Filip-Kin/frc-radio-kiosk/Radio_Kiosk_v2b/render-iso.png

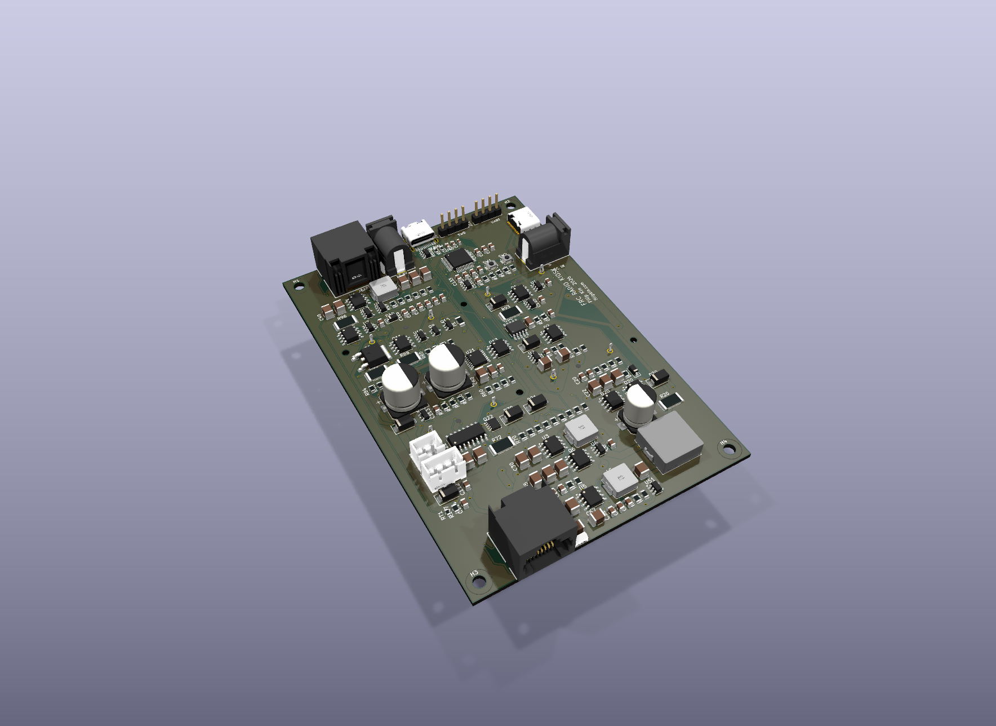
Radio_Kiosk_v2b/render-iso.png
