Filip-Kin/frc-radio-kiosk/Radio_Kiosk_v2d/loon-layout.png

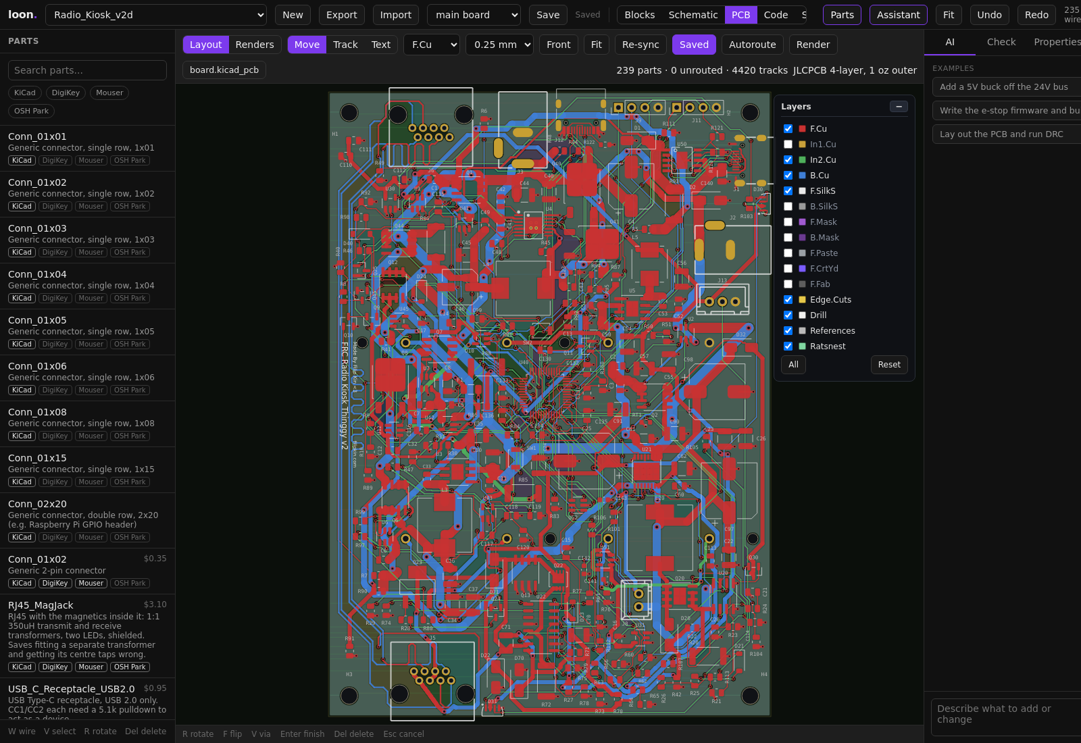
Radio_Kiosk_v2d/loon-layout.png
