Filip-Kin/frc-radio-kiosk/Radio_Kiosk_v2b/NETS-CHANGED.md

# Net changes, schematic 68f2993 -> 1c7bf27 (2026-09-24)

## New parts

C3 C4 C5 C8 C12 C13 C14 C15 C16 C26 C48 C49 C119 C120 D23 Q12 Q23 Q24 Q25 Q40 Q41 R5 R6 R27 R28 R29 R44 R45 R46 R47 R64 R65 R66 R113 U12 U31

## Existing pads that moved to another net

| pad | was | now |
|---|---|---|
| C23.1 | PORT_P | BOOST_OUT |
| C24.1 | PORT_P | BOOST_OUT |
| C25.1 | PORT_P | BOOST_OUT |
| C43.1 | U4_BOOT | U4_BST |
| C44.1 | +15V6_BUCK | VIN |
| C50.1 | VIN | +12V |
| C51.1 | VIN | +12V |
| D20.1 | PORT_P | BOOST_OUT |
| D22.2 | PORT_N | GND |
| D30.1 | LED_D0 | LED_D0R |
| D71.1 | PSE_AGND | PORT_P |
| J13.2 | LED_D2 | LED_D2W |
| Q8.3 | PACK_F | BK_MID |
| Q9.2 | GND | BK_ARM |
| Q10.1 | BK_KILL | BK_EN |
| Q10.3 | BK_DRV | BK_ARM |
| Q11.1 | GND | TEST_LOAD |
| Q11.3 | GND | TEST_NODE |
| Q13.4 | PASSIVE_EN | PASSIVE_EN5 |
| R22.1 | PORT_P | BOOST_OUT |
| R40.1 | +15V6_BUCK | U4_FB |
| R40.2 | U4_FB | GND |
| R41.1 | U4_FB | +15V6_BUCK |
| R41.2 | GND | U4_FB |
| R80.1 | PACK_F | BK_MID |
| R85.1 | PACK_F | BK_MID |
| R86.1 | PACK_F | BK_MID |
| R88.1 | PACK_F | BK_MID |
| R89.1 | BK_KILL | BK_EN |
| R92.1 | LAPTOP_EN | U4_EN |
| R103.2 | LED_D0 | LED_D0R |
| U1.3 | VIN_USBS | USB_EN |
| U4.1 | GND | U4_VCC |
| U4.3 | LAPTOP_EN | U4_EN |
| U4.4 | N$5 | U4_FB |
| U4.5 | U4_FB | GND |
| U4.6 | U4_VCC | U4_SS |
| U4.7 | U4_BOOT | U4_RON |
| U4.8 | U4_SW | U4_ILIM |
| U5.2 | VIN | +12V |
| U5.3 | VIN | +12V |
| U21.3 | GND | +12V |
| U40.18 | N$25 | PORT_SENSE |
| U40.31 | BK_KILL | BK_EN |
| U40.38 | N$26 | PORT_SW |
| U40.46 | N$27 | USB_DIS |
| U43.1 | LAPTOP_ISENSE | LAPTOP_CC |
| U43.3 | LAPTOP_ILIM_N | LAPTOP_ISENSE_F |
| U43.4 | LAPTOP_CC | LAPTOP_ILIM_N |

## Nets gone

BK_KILL U4_BOOT

## Nets new

BK_ARM BK_EN BK_MID BOOST_OUT LAPTOP_ISENSE_F LED_D0R LED_D2W PASSIVE_EN5 PORT_SENSE PORT_SW PORT_SW_D PORT_SW_G U12_GATE U12_VCAP U4_BST U4_EN U4_HG U4_ILIM U4_LG U4_RON U4_SS USB_DIS USB_EN
