Filip-Kin/frc-radio-kiosk/Radio_Kiosk_v2/layers.png

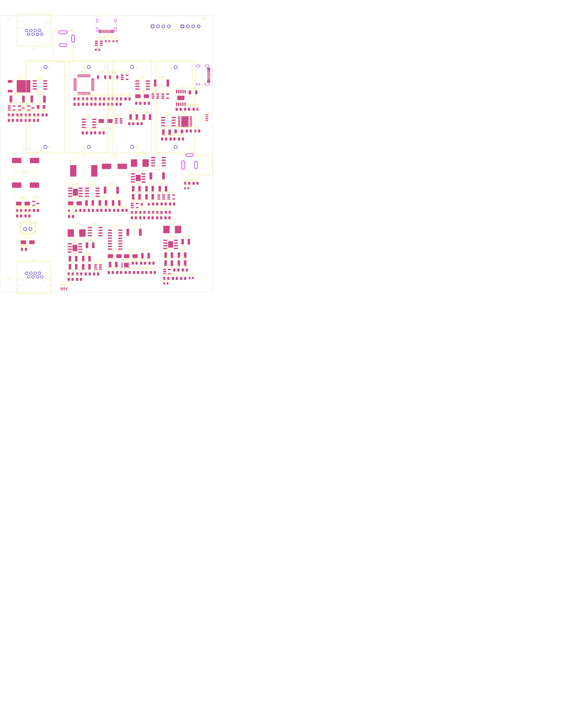
Radio_Kiosk_v2/layers.png
