Filip-Kin/frc-radio-kiosk/Radio_Kiosk_v2/render-bottom.png

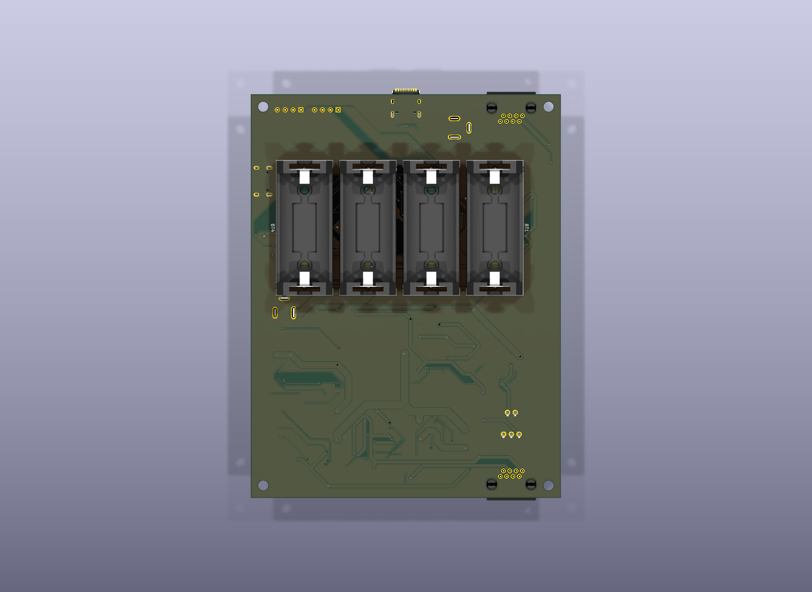
Radio_Kiosk_v2/render-bottom.png
