Filip-Kin/frc-radio-kiosk/Radio_Kiosk_v2/render-top.png

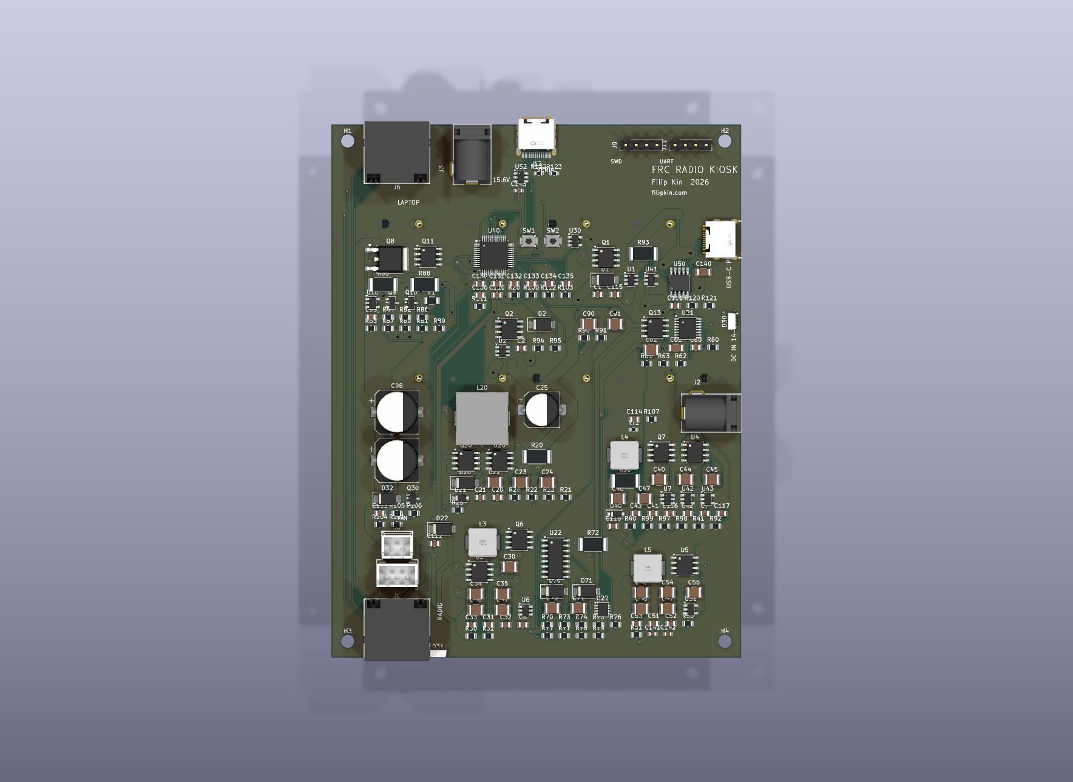
Radio_Kiosk_v2/render-top.png
