Filip-Kin/frc-radio-kiosk/Radio_Kiosk_v2b/audit-top.png

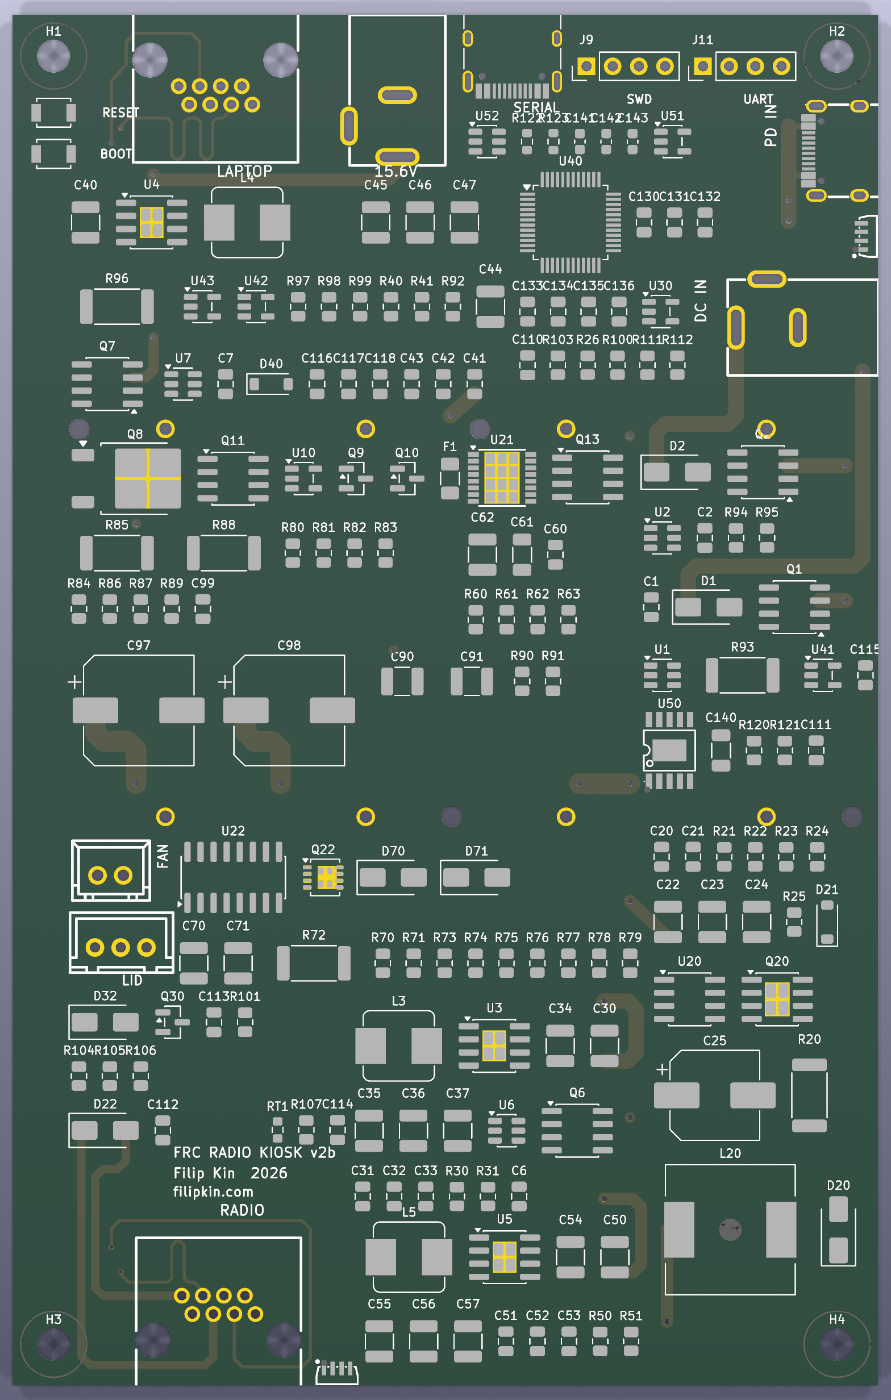
Radio_Kiosk_v2b/audit-top.png
