Filip-Kin/frc-radio-kiosk/Radio_Kiosk_v2b/d30-tilt.png

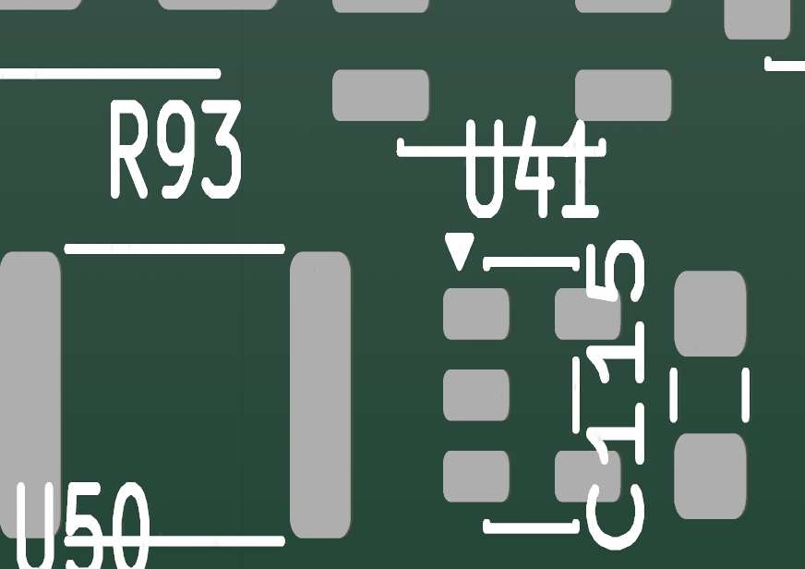
Radio_Kiosk_v2b/d30-tilt.png
