Filip-Kin/frc-radio-kiosk/Radio_Kiosk_v2b/d31-tilt.png

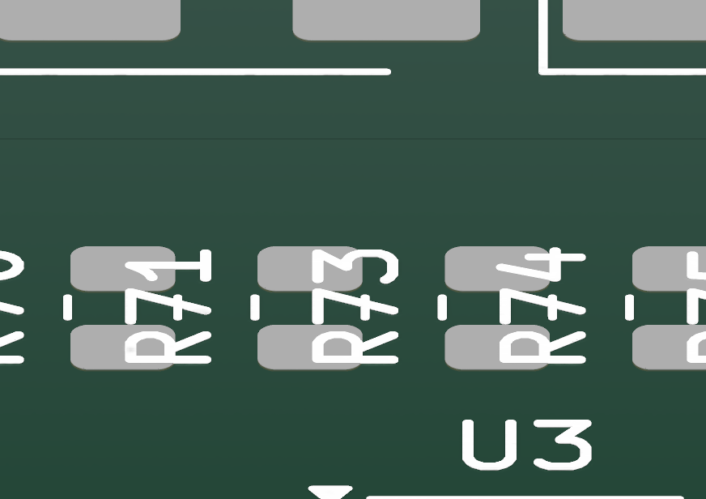
Radio_Kiosk_v2b/d31-tilt.png
