Filip-Kin/frc-radio-kiosk/Radio_Kiosk_v2b/d31-top.png

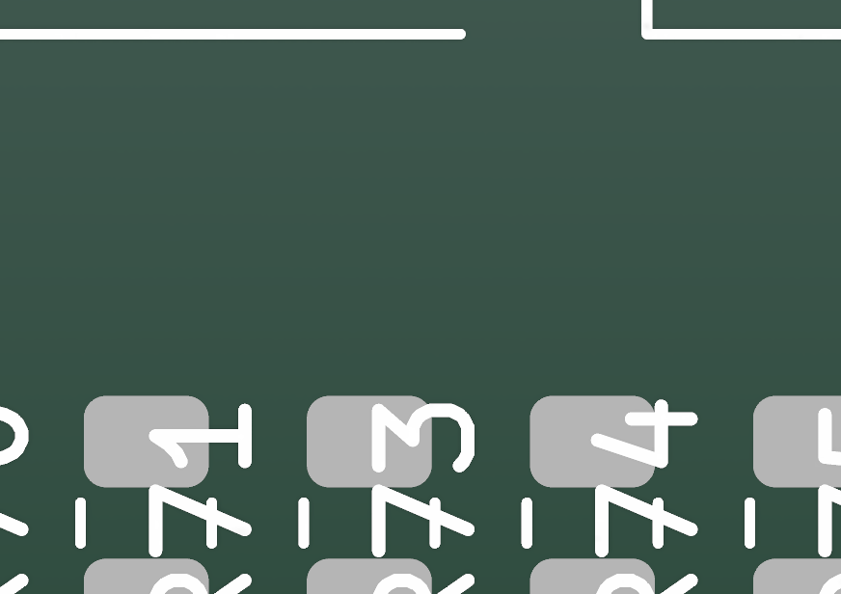
Radio_Kiosk_v2b/d31-top.png
