Filip-Kin/frc-radio-kiosk/Radio_Kiosk_v2b/render-bottom.png

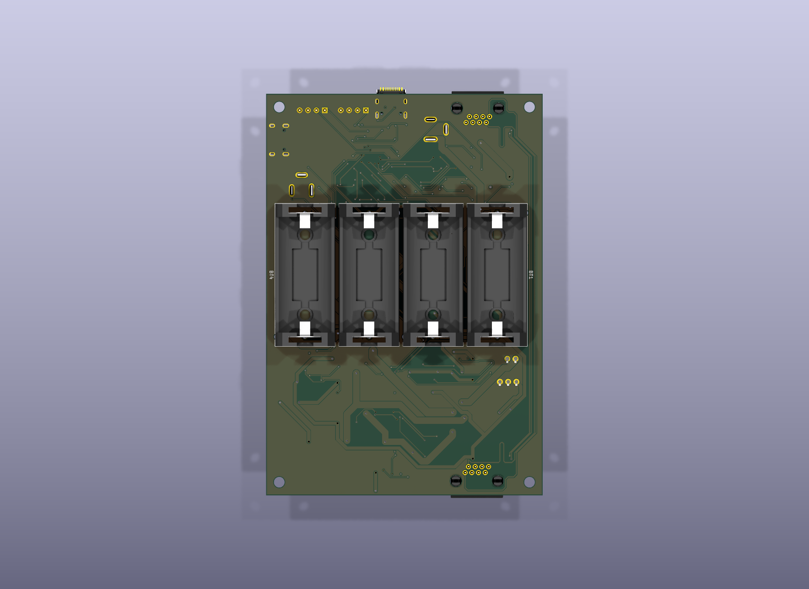
Radio_Kiosk_v2b/render-bottom.png
