Filip-Kin/frc-radio-kiosk/Radio_Kiosk_v2b/render-top.png

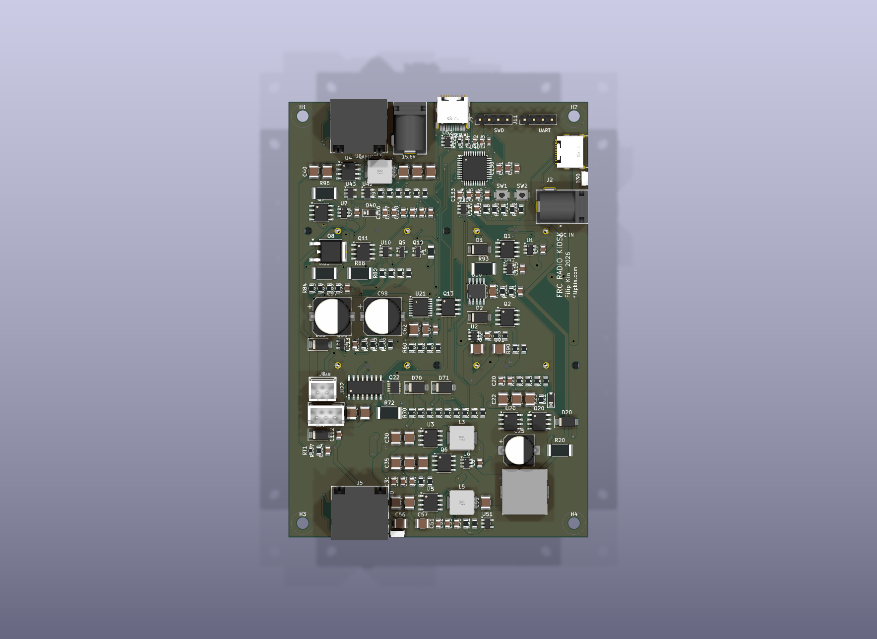
Radio_Kiosk_v2b/render-top.png
