Filip-Kin/frc-radio-kiosk/Radio_Kiosk_v2d/plot-layers.png

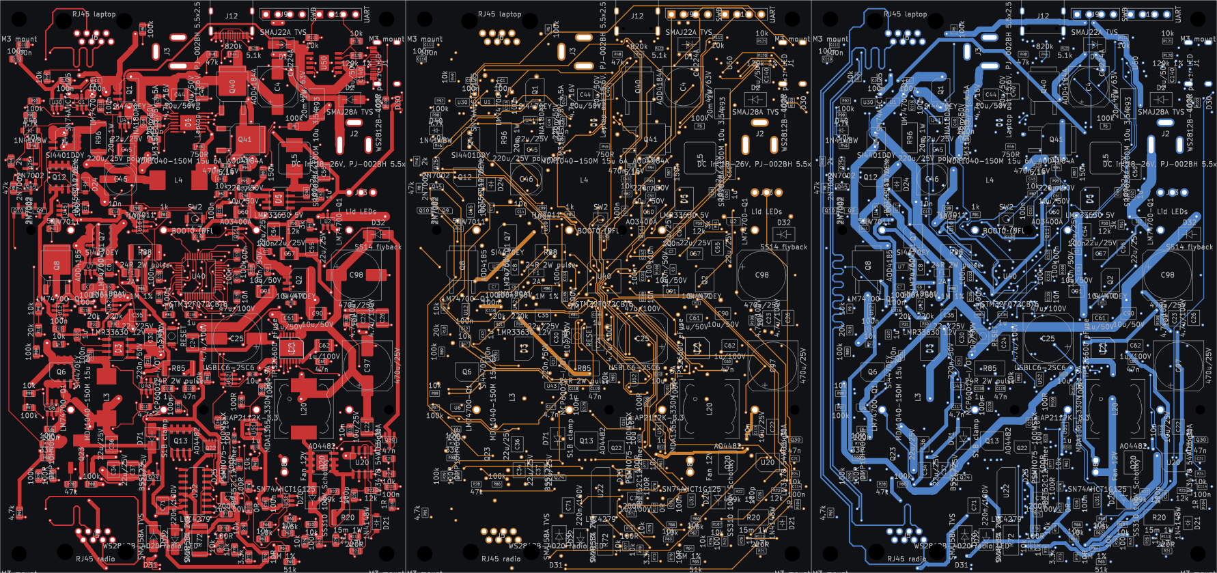
Radio_Kiosk_v2d/plot-layers.png
