Filip-Kin/frc-radio-kiosk/Radio_Kiosk_v2d/plot-top.png

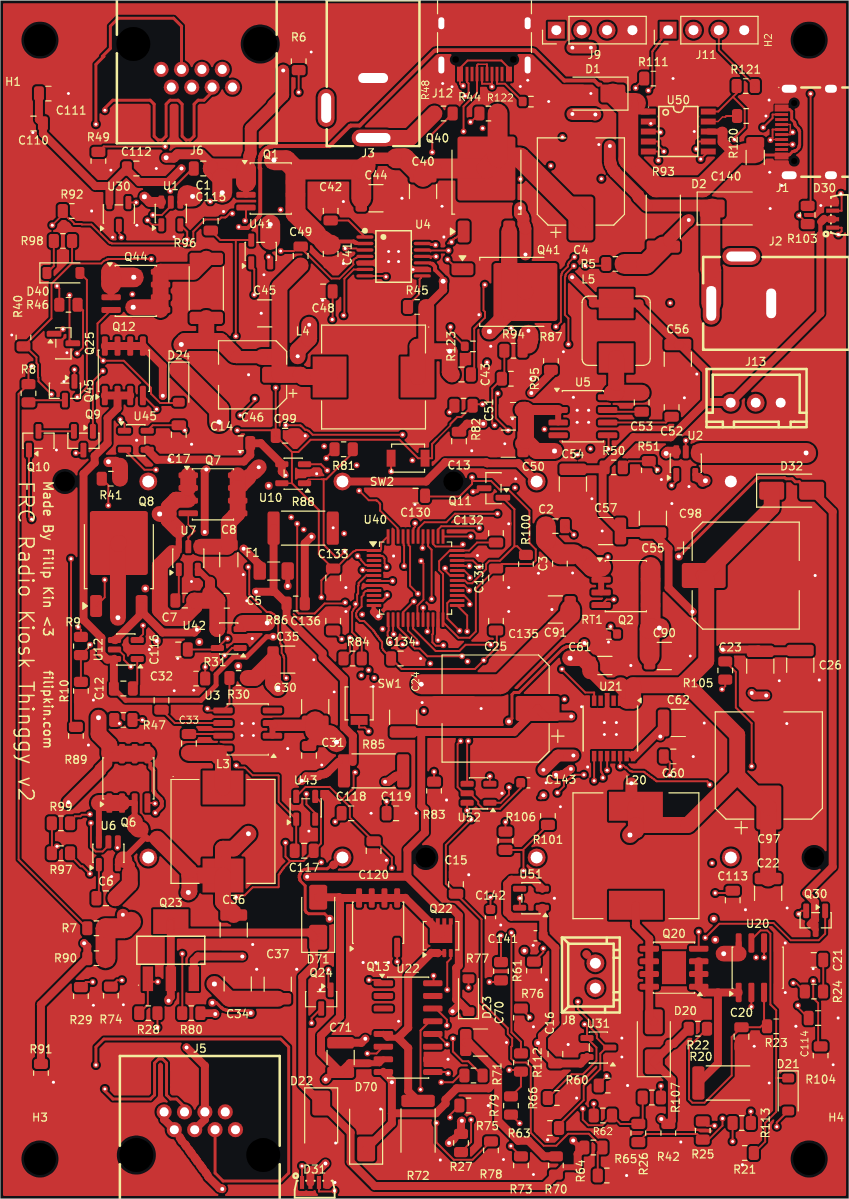
Radio_Kiosk_v2d/plot-top.png
