Filip-Kin/frc-radio-kiosk/Radio_Kiosk_v2d/fab/v2d-bom-jlc-smt-tht.xlsx

Comment | Designator | Footprint | LCSC Part #
100n | C1,C2,C6,C7,C12,C13,C16,C17,C33,C48,C53,C99,C110,C111,C112,C114,C115,C116,C120,C131,C132,C133,C136 | C_0805_2012Metric | C28233
100n/50V | C3,C5 | C_0805_2012Metric | C49678
47u/63V | C4 | CP_Elec_8x10.5 | C970680
1u/50V | C8,C61,C140 | C_1206_3216Metric | C1848
10n | C14,C15,C113,C135 | C_0805_2012Metric | C1710
100p | C20 | C_0805_2012Metric | C1790
47n | C21,C60,C119 | C_0805_2012Metric | C53134
10u/25V | C22 | C_1210_3225Metric | C53084452
4.7u/100V | C23,C24,C26 | C_1210_3225Metric | C337978
47u/100V | C25 | CP_Elec_10x10.5 | C970681
10u/50V | C30,C40,C50,C90,C91,C44 | C_1210_3225Metric | C53084452
220n/50V | C31,C41,C51 | C_0805_2012Metric | C5378
1u | C32,C52,C118,C134 | C_0805_2012Metric | C28323
22u/25V | C34,C35,C36,C37,C45,C54,C55,C56,C57 | C_1210_3225Metric | C53084530
4.7u/16V | C42 | C_0805_2012Metric | C1779
470n/16V | C43 | C_0805_2012Metric | C13967
220u/25V polymer | C46 | CP_Elec_6.3x7.7 | C2981459
2.2n | C49 | C_0805_2012Metric | C28260
1u/100V | C62,C70 | C_1210_3225Metric | C24365
220n/100V | C71 | C_1210_3225Metric | C72067
470u/25V | C97,C98 | CP_Elec_10x10.5 | C346948
4.7n | C117 | C_0805_2012Metric | C1744
4.7u | C130 | C_0805_2012Metric | C1779
1u | C141 | C_0603_1608Metric | C15849
10u | C142,C143 | C_0603_1608Metric | C19702
SMAJ22A TVS | D1 | D_SMA | C148220
SMAJ28A TVS | D2 | D_SMA | C148227
SS310 100V Schottky | D20 | D_SMA | C15874
1N4148W | D21,D40 | D_SOD-123 | C81598
SMAJ58A TVS | D22,D70 | D_SMA | C10762
BZT52C12 zener | D23,D24 | D_SOD-123 | C12747
WS2812B-4020 power LED | D30 | LED-SMD_WS2812B-4020 | C965557
WS2812B-4020 radio LED | D31 | LED-SMD_WS2812B-4020 | C965557
SS14 flyback | D32 | D_SMA | C2480
S1B clamp | D71 | D_SMA | C96324
2A | F1 | Fuse_1206_3216Metric | C2838912
USB-C PD in | J1 | USB-C_TYPE-C-31-M-12 | C165948
DC in 18-26V, PJ-002BH 5.5x2.5 | J2 | DC-IN-TH_PJ-002BH | C22359705
Laptop out 15.6V, PJ-002BH 5.5x2.5 (v1 jack) | J3 | DC-IN-TH_PJ-002BH | C22359705
RJ45 radio | J5 | RJ45-TH_R-RJ45R08P-A004 | C385834
RJ45 laptop | J6 | RJ45-TH_R-RJ45R08P-A004 | C385834
Fan 12V | J8 | CONN-TH_XH-2A | C20079
USB-C | J12 | USB_C_Receptacle_HRO_TYPE-C-31-M-12 | C165948
Lid LEDs | J13 | CONN-TH_XH-3A | C2316
MDA1040-150M 15u 6A | L3,L4 | IND-SMD_L10.0-W10.0-APS10A40M470 | C2847554
SRP7028A-100M 10u 3.5A | L5 | L_Bourns_SRP7028A_7.3x6.6mm | C2687402
MDA1365-330M 33u 9A | L20 | L_12x12mm_H8mm | C2847586
SI4470EY | Q1,Q2,Q6,Q7,Q12 | SOIC-8_3.9x4.9mm_P1.27mm | C7568913
AOD4185 | Q8 | TO-252-2 | C400894
2N7002 | Q9,Q10,Q25,Q45 | SOT-23 | C8545
AO3400A | Q11,Q30 | SOT-23 | C20917
AO4482 | Q13,Q20 | SOIC-8_3.9x4.9mm_P1.27mm | C192576
PSMN075-100MSEX | Q22 | LFPAK33 | C478016
DMP10H400SE | Q23 | SOT-223_L6.5-W3.5-P2.30-LS7.0-BR | C156277
BSS123 | Q24 | SOT-23 | C78755
AOD4184A | Q40,Q41 | TO-252-2 | C99124
SI4401DDY | Q44 | SOIC-8_3.9x4.9mm_P1.27mm | C72317
100k | R5,R6,R29,R42,R80,R89,R92,R97,R100,R101 | R_0805_2012Metric | C149504
10k | R7,R9,R24,R26,R27,R46,R47,R49,R61,R62,R63,R66,R78,R79,R82,R83,R99,R105,R107,R111,R121 | R_0805_2012Metric | C17414
47k | R8,R21,R28,R48 | R_0805_2012Metric | C17713
20k | R10,R31 | R_0805_2012Metric | C4328
15m 1W | R20 | R_2512_6332Metric | C44883
499k 1% | R22 | R_0805_2012Metric | C17721
12k | R23,R50 | R_0805_2012Metric | C17444
1k | R25,R81 | R_0805_2012Metric | C17513
220k | R30 | R_0805_2012Metric | C17556
2k | R40 | R_0805_2012Metric | C17604
51k | R41,R65 | R_0805_2012Metric | C17737
820k | R44 | R_0805_2012Metric | C50136
750R | R45 | R_0805_2012Metric | C17818
3k | R51 | R_0805_2012Metric | C17661
5.6k | R60 | R_0805_2012Metric | C4382
1M 1% | R64,R86 | R_0805_2012Metric | C17514
10R | R70 | R_0805_2012Metric | C17415
200R | R71 | R_0805_2012Metric | C17540
0.1R 1% 2W | R72 | R_2512_6332Metric | C844904
3.3k | R73 | R_0805_2012Metric | C26010
100R | R74,R75,R76,R77,R103,R106 | R_0805_2012Metric | C17408
1M | R84 | R_0805_2012Metric | C17514
24R 2W pulse | R85,R88 | R_2512_6332Metric | C25476
150k | R87 | R_0805_2012Metric | C17470
33k | R90,R94 | R_0805_2012Metric | C17633
4.7k | R91,R95,R98 | R_0805_2012Metric | C17673
20m 1W | R93,R96 | R_2512_6332Metric | C2885416
1R | R104 | R_0805_2012Metric | C25271
0R | R112 | R_0805_2012Metric | C17477
220R | R113 | R_0805_2012Metric | C17557
120k 1% | R120 | R_0805_2012Metric | C17436
5.1k | R122,R123 | R_0603_1608Metric | C23186
10k NTC | RT1 | R_0603_1608Metric | C13564
RESET | SW1 | SW_SPST_B3U-1000P | C231329
BOOT0 (DFU) | SW2 | SW_SPST_B3U-1000P | C231329
LM74700-Q1 | U1,U2,U6,U7,U12 | SOT-23-6 | C2941042
LMR33630 12V | U3 | SOIC-8-1EP_3.9x4.9mm_P1.27mm_EP2.29x3mm | C841384
LM3150 15.75V 4.5A | U4 | HTSSOP-14_L5.0-W4.4-P0.65-LS6.4-BL-EP | C48112
LMR33630 5V | U5 | SOIC-8-1EP_3.9x4.9mm_P1.27mm_EP2.29x3mm | C841384
TLV7011 | U10,U45 | SOT-23-5 | C702117
LM3478 54V boost | U20 | SOIC-8_3.9x4.9mm_P1.27mm | C115907
TPS26600 eFuse | U21 | HTSSOP-16-1EP_4.4x5mm_P0.65mm_EP3.4x5mm | C544399
LTC4279 | U22 | SOIC-16_3.9x9.9mm_P1.27mm | C687935
SN74AHCT1G125 | U30,U31 | SOT-23-5 | C7484
STM32F072CBT6 | U40 | LQFP-48_7x7mm_P0.5mm | C81720
INA180A1 | U41,U42 | SOT-23-5 | C122228
MCP6001T-I/OT | U43 | SOT-23-5 | C116490
CH224A | U50 | ESSOP-10_CH224A | C42459160
AP2112K-3.3 | U51 | SOT-23-5 | C51118
USBLC6-2SC6 | U52 | SOT-23-6 | C7519
