Filip-Kin/frc-radio-kiosk/Radio_Kiosk_v1/fab/3D_PCB1_2026-03-25.step

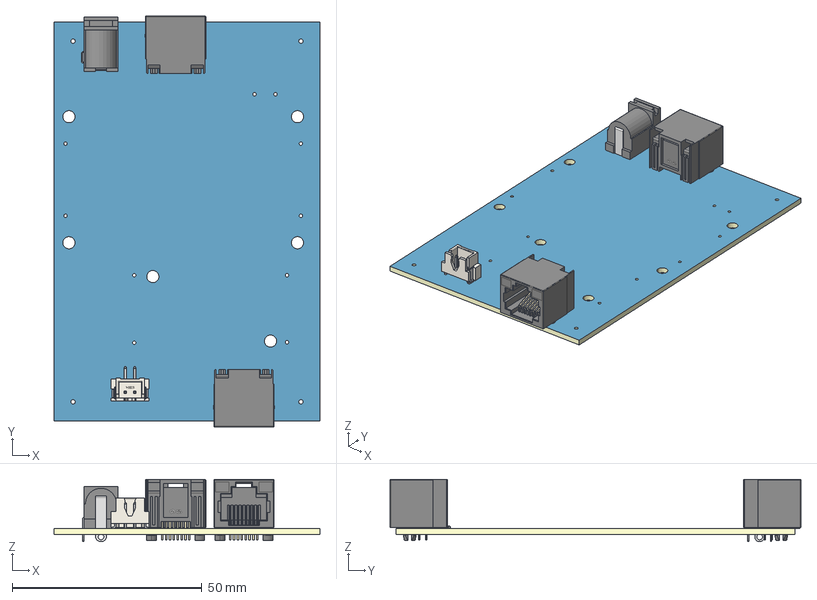
[picture p15: CAD file, 2026-10-11, an earlier design]
Radio_Kiosk_v1/fab/3D_PCB1_2026-03-25.step
70.0 x 108.3 x 16.4 mm
Board~hxvB
TopCopper~hxvB
BottomCopper~hxvB
TopFpcStiffener~hxvB
BottomFpcStiffener~hxvB
CONN-SMD_2P-P2.54_XH2.54-2AB~CONN-SMD_XH2.54-LS-2P~hxvB
DC-IN-TH_PJ-002BH~DC-IN-TH_PJ-002BH~hxvB
RJ45-TH_R-RJ45R08P-A004~RJ45-TH_L15.9-W15.1-H12.6~hxvB x 2
