Filip-Kin/frc-radio-kiosk/Radio_Kiosk_v2d/board.kicad_pcb

## KiCad design Radio_Kiosk_v2d/board.kicad_pcb (2026-09-26)

Schematic: board.kicad_sch, FRC Radio Kiosk v2

Parts:
BT1, BT2, BT3, BT4: CR123A; BAT-TH_BH-123A-A5BJ002; LCSC C5290177
C1, C2, C6, C7, C12, C13, C16, C17, C33, C48, C53, C99, C110, C111, C112, C114, C115, C116, C120, C131, C132, C133, C136: 100n; C_0805_2012Metric; LCSC C28233
C3, C5: 100n/50V; C_0805_2012Metric; LCSC C49678
C4: 47u/63V; CP_Elec_8x10.5; LCSC C970680
C8, C61, C140: 1u/50V; C_1206_3216Metric; LCSC C1848
C14, C15, C113, C135: 10n; C_0805_2012Metric; LCSC C1710
C20: 100p; C_0805_2012Metric; LCSC C1790
C21, C60, C119: 47n; C_0805_2012Metric; LCSC C53134
C22: 10u/25V; C_1210_3225Metric; LCSC C53084452
C23, C24, C26: 4.7u/100V; C_1210_3225Metric; LCSC C337978
C25: 47u/100V; CP_Elec_10x10.5; LCSC C970681
C30, C40, C44, C50, C90, C91: 10u/50V; C_1210_3225Metric; LCSC C53084452
C31, C41, C51: 220n/50V; C_0805_2012Metric; LCSC C5378
C32, C52, C118, C134: 1u; C_0805_2012Metric; LCSC C28323
C34, C35, C36, C37, C45, C54, C55, C56, C57: 22u/25V; C_1210_3225Metric; LCSC C53084530
C42: 4.7u/16V; C_0805_2012Metric; LCSC C1779
C43: 470n/16V; C_0805_2012Metric; LCSC C13967
C46: 220u/25V polymer; CP_Elec_6.3x7.7; LCSC C2981459
C49: 2.2n; C_0805_2012Metric; LCSC C28260
C62, C70: 1u/100V; C_1210_3225Metric; LCSC C24365
C71: 220n/100V; C_1210_3225Metric; LCSC C72067
C97, C98: 470u/25V; CP_Elec_10x10.5; LCSC C346948
C117: 4.7n; C_0805_2012Metric; LCSC C1744
C130: 4.7u; C_0805_2012Metric; LCSC C1779
C141: 1u; C_0603_1608Metric; LCSC C15849
C142, C143: 10u; C_0603_1608Metric; LCSC C19702
D1: SMAJ22A TVS; D_SMA; LCSC C148220
D2: SMAJ28A TVS; D_SMA; LCSC C148227
D20: SS310 100V Schottky; D_SMA; LCSC C15874
D21, D40: 1N4148W; D_SOD-123; LCSC C81598
D22, D70: SMAJ58A TVS; D_SMA; LCSC C10762
D23, D24: BZT52C12 zener; D_SOD-123; LCSC C12747
D30: WS2812B-4020 power LED; LED-SMD_WS2812B-4020; LCSC C965557
D31: WS2812B-4020 radio LED; LED-SMD_WS2812B-4020; LCSC C965557
D32: SS14 flyback; D_SMA; LCSC C2480
D71: S1B clamp; D_SMA; LCSC C96324
F1: 2A; Fuse_1206_3216Metric; LCSC C2838912
J1: USB-C PD in; USB-C_TYPE-C-31-M-12; LCSC C165948
J2: DC in 18-26V, PJ-002BH 5.5x2.5; DC-IN-TH_PJ-002BH; LCSC C22359705
J3: Laptop out 15.6V, PJ-002BH 5.5x2.5 (v1 jack); DC-IN-TH_PJ-002BH; LCSC C22359705
J5: RJ45 radio; RJ45-TH_R-RJ45R08P-A004; LCSC C385834
J6: RJ45 laptop; RJ45-TH_R-RJ45R08P-A004; LCSC C385834
J8: Fan 12V; CONN-TH_XH-2A; LCSC C20079
J9: SWD; PinHeader_1x04_P2.54mm_Vertical
J11: UART; PinHeader_1x04_P2.54mm_Vertical
J12: USB-C; USB_C_Receptacle_HRO_TYPE-C-31-M-12; LCSC C165948
J13: Lid LEDs; CONN-TH_XH-3A; LCSC C2316
L3, L4: MDA1040-150M 15u 6A; IND-SMD_L10.0-W10.0-APS10A40M470; LCSC C2847554
L5: SRP7028A-100M 10u 3.5A; L_Bourns_SRP7028A_7.3x6.6mm; LCSC C2687402
L20: MDA1365-330M 33u 9A; L_12x12mm_H8mm; LCSC C2847586
Q1, Q2, Q6, Q7, Q12: SI4470EY; SOIC-8_3.9x4.9mm_P1.27mm; LCSC C7568913
Q8: AOD4185; TO-252-2; LCSC C400894
Q9, Q10, Q25, Q45: 2N7002; SOT-23; LCSC C8545
Q11, Q30: AO3400A; SOT-23; LCSC C20917
Q13, Q20: AO4482; SOIC-8_3.9x4.9mm_P1.27mm; LCSC C192576
Q22: PSMN075-100MSEX; LFPAK33; LCSC C478016
Q23: DMP10H400SE; SOT-223_L6.5-W3.5-P2.30-LS7.0-BR; LCSC C156277
Q24: BSS123; SOT-23; LCSC C78755
Q40, Q41: AOD4184A; TO-252-2; LCSC C99124
Q44: SI4401DDY; SOIC-8_3.9x4.9mm_P1.27mm; LCSC C72317
R5, R6, R29, R42, R80, R89, R92, R97, R100, R101: 100k; R_0805_2012Metric; LCSC C149504
R7, R9, R24, R26, R27, R46, R47, R49, R61, R62, R63, R66, R78, R79, R82, R83, R99, R105, R107, R111, R121: 10k; R_0805_2012Metric; LCSC C17414
R8, R21, R28, R48: 47k; R_0805_2012Metric; LCSC C17713
R10, R31: 20k; R_0805_2012Metric; LCSC C4328
R20: 15m 1W; R_2512_6332Metric; LCSC C44883
R22: 499k 1%; R_0805_2012Metric; LCSC C17721
R23, R50: 12k; R_0805_2012Metric; LCSC C17444
R25, R81: 1k; R_0805_2012Metric; LCSC C17513
R30: 220k; R_0805_2012Metric; LCSC C17556
R40: 2k; R_0805_2012Metric; LCSC C17604
R41, R65: 51k; R_0805_2012Metric; LCSC C17737
R44: 820k; R_0805_2012Metric; LCSC C50136
R45: 750R; R_0805_2012Metric; LCSC C17818
R51: 3k; R_0805_2012Metric; LCSC C17661
R60: 5.6k; R_0805_2012Metric; LCSC C4382
R64, R86: 1M 1%; R_0805_2012Metric; LCSC C17514
R70: 10R; R_0805_2012Metric; LCSC C17415
R71: 200R; R_0805_2012Metric; LCSC C17540
R72: 0.1R 1% 2W; R_2512_6332Metric; LCSC C844904
R73: 3.3k; R_0805_2012Metric; LCSC C26010
R74, R75, R76, R77, R103, R106: 100R; R_0805_2012Metric; LCSC C17408
R84: 1M; R_0805_2012Metric; LCSC C17514
R85, R88: 24R 2W pulse; R_2512_6332Metric; LCSC C25476
R87: 150k; R_0805_2012Metric; LCSC C17470
R90, R94: 33k; R_0805_2012Metric; LCSC C17633
R91, R95, R98: 4.7k; R_0805_2012Metric; LCSC C17673
R93, R96: 20m 1W; R_2512_6332Metric; LCSC C2885416
R104: 1R; R_0805_2012Metric; LCSC C25271
R112: 0R; R_0805_2012Metric; LCSC C17477
R113: 220R; R_0805_2012Metric; LCSC C17557
R120: 120k 1%; R_0805_2012Metric; LCSC C17436
R122, R123: 5.1k; R_0603_1608Metric; LCSC C23186
RT1: 10k NTC; R_0603_1608Metric; LCSC C13564
SW1: RESET; SW_SPST_B3U-1000P; LCSC C231329
SW2: BOOT0 (DFU); SW_SPST_B3U-1000P; LCSC C231329
U1, U2, U6, U7, U12: LM74700-Q1; SOT-23-6; LCSC C2941042
U3: LMR33630 12V; SOIC-8-1EP_3.9x4.9mm_P1.27mm_EP2.29x3mm; LCSC C841384
U4: LM3150 15.75V 4.5A; HTSSOP-14_L5.0-W4.4-P0.65-LS6.4-BL-EP; LCSC C48112
U5: LMR33630 5V; SOIC-8-1EP_3.9x4.9mm_P1.27mm_EP2.29x3mm; LCSC C841384
U10, U45: TLV7011; SOT-23-5; LCSC C702117
U20: LM3478 54V boost; SOIC-8_3.9x4.9mm_P1.27mm; LCSC C115907
U21: TPS26600 eFuse; HTSSOP-16-1EP_4.4x5mm_P0.65mm_EP3.4x5mm; LCSC C544399
U22: LTC4279; SOIC-16_3.9x9.9mm_P1.27mm; LCSC C687935
U30, U31: SN74AHCT1G125; SOT-23-5; LCSC C7484
U40: STM32F072CBT6; LQFP-48_7x7mm_P0.5mm; LCSC C81720
U41, U42: INA180A1; SOT-23-5; LCSC C122228
U43: MCP6001T-I/OT; SOT-23-5; LCSC C116490
U50: CH224A; ESSOP-10_CH224A; LCSC C42459160
U51: AP2112K-3.3; SOT-23-5; LCSC C51118
U52: USBLC6-2SC6; SOT-23-6; LCSC C7519

Connections:
+3V3: C17.1, C99.1, C115.1, C116.1, C120.1, C130.1, C131.1, C132.1, C133.1, C142.1, J9.3, J11.3, R26.1, R62.1, R79.1, R82.1, R107.1, R112.1, R121.1, SW2.2, U10.5 (VCC), U40.1 (VBAT), U40.24 (VDD), U40.36 (VDDIO2), U40.48 (VDD), U41.5 (VS), U42.5 (VS), U43.5 (VDD), U45.5 (VCC), U51.5 (VOUT)
+5V: C16.1, C54.1, C55.1, C56.1, C57.1, C110.1, C111.1, C112.1, C141.1, D30.2 (VDD), D31.2 (VDD), J13.1 (5V), L5.2, R50.1, U30.5 (VCC), U31.5 (VCC), U51.1 (VIN), U51.3 (EN)
+12V: C22.1, C50.1, C51.1, C61.1, C97.1, C98.1, D32.1 (K), J8.1, L20.1, Q6.5 (D), Q6.6 (D), Q6.7 (D), Q6.8 (D), Q8.2 (D), U5.2 (VIN), U5.3 (EN), U6.4 (CATHODE), U20.8 (VIN), U21.1 (IN), U21.2 (IN), U21.3 (UVLO)
+12V_BUCK: C6.2, C34.1, C35.1, C36.1, C37.1, L3.2, Q6.1 (S), Q6.2 (S), Q6.3 (S), R30.1, U6.3 (EN), U6.6 (ANODE)
+15V6_BUCK: C45.1, C46.1, C49.1, L4.2, R41.1, R96.1, U42.3 (IN+)
+15V6_S: C5.1, C7.2, Q7.1 (S), Q7.2 (S), Q7.3 (S), Q44.5 (D), Q44.6 (D), Q44.7 (D), Q44.8 (D), R96.2, U7.3 (EN), U7.6 (ANODE), U42.4 (IN-)
BK_ARM: Q9.2 (S), Q10.3 (D)
BK_DRV: Q9.1 (G), R81.2
BK_EN: Q10.1 (G), R89.1, U12.3 (EN), U40.5 (PF0/OSC_IN)
BK_GATE: Q8.1 (G), Q9.3 (D), R80.2
BK_MID: Q8.3 (S), Q12.5 (D), Q12.6 (D), Q12.7 (D), Q12.8 (D), R80.1, R85.1, R86.1, R88.1, U12.4 (CATHODE)
BK_ON: R81.1, R84.1, U10.1 (OUT), U40.6 (PF1/OSC_OUT)
BK_REF: R82.2, R83.1, R84.2, U10.3 (IN+)
BOOST_COMP: R24.1, U20.2 (COMP)
BOOST_COMPC: C21.1, R24.2
BOOST_CS: Q20.1 (S), Q20.2 (S), Q20.3 (S), R20.1, U20.1 (ISEN)
BOOST_DR: Q20.4 (G), U20.6 (DR)
BOOST_FA: D21.1 (K), R21.1, U20.7 (FA/SD)
BOOST_FB: C20.1, R22.2, R23.1, U20.3 (FB)
BOOST_OUT: C23.1, C24.1, C25.1, C26.1, D20.1 (K), D23.1 (K), Q23.3 (S), R22.1, R27.1, R42.1
BOOST_SD: R25.1, R26.2, U40.27 (PB14)
BOOST_SDD: D21.2 (A), R25.2
BOOST_SW: D20.2 (A), L20.2, Q20.5 (D), Q20.6 (D), Q20.7 (D), Q20.8 (D)
BYP_D: Q45.3 (D), R8.2
BYP_EN: Q45.1 (G), U45.1 (OUT)
BYP_G: D24.2 (A), Q44.4 (G), R7.2, R8.1
BYP_REF: R9.2, R10.1, U45.3 (IN+)
CC1: J12.A5 (CC1), R122.1
CC2: J12.B5 (CC2), R123.1
DCIN_SENSE: R94.2, R95.1, U40.19 (PB1/ADC9)
ETH_1: J5.1, J6.1
ETH_2: J5.2, J6.2
ETH_3: J5.3, J6.3
ETH_6: J5.6, J6.6
FAN_G: Q30.1 (G), R101.1, R106.2
FAN_N: D32.2 (A), J8.2, Q30.3 (D)
FAN_PWM: R106.1, U40.40 (PB4)
FAN_SENSE: C113.1, R105.2, U40.18 (PB0/ADC8)
FAN_SHUNT: Q30.2 (S), R104.1, R105.1
GND: BT4.2 (-), C3.2, C4.2, C5.2, C8.2, C13.2, C14.2, C15.2, C16.2, C17.2, C20.2, C21.2, C22.2, C23.2, C24.2, C25.2, C26.2, C30.2, C31.2, C32.2, C34.2, C35.2, C36.2, C37.2, C40.2, C41.2, C42.2, C44.2, C45.2, C46.2, C48.2, C50.2, C51.2, C52.2, C54.2, C55.2, C56.2, C57.2, C60.2, C61.2, C62.2, C70.2, C90.2, C91.2, C97.2, C98.2, C99.2, C110.2, C111.2, C112.2, C113.2, C114.2, C115.2, C116.2, C118.2, C119.2, C120.2, C130.2, C131.2, C132.2, C133.2, C134.2, C135.2, C136.2, C140.2, C141.2, C142.2, C143.2, D1.2 (A), D2.2 (A), D22.2 (A), D30.4 (VSS), D31.4 (VSS), D70.2 (A), J1.1 (SHELL), J1.2 (SHELL), J1.3 (SHELL), J1.4 (SHELL), J1.A1B12 (GND), J1.B1A12 (GND), J2.2 (GND), J3.2 (GND), J9.4, J11.4, J12.A1 (GND), J12.A12, J12.B1 (GND2), J12.B12, J12.S1 (SHIELD), J13.3 (GND), Q10.2 (S), Q11.2 (S), Q13.1 (S), Q13.2 (S), Q13.3 (S), Q24.2 (S), Q25.2 (S), Q41.3 (S), Q45.2 (S), R6.2, R10.2, R20.2, R21.2, R23.2, R29.2, R31.2, R40.2, R42.2, R49.2, R51.2, R60.2, R61.2, R63.2, R65.2, R66.2, R72.2, R73.2, R74.2, R75.2, R76.2, R78.2, R83.2, R87.2, R89.2, R91.2, R92.2, R95.2, R100.2, R101.2, R104.2, R111.2, R120.2, R122.2, R123.2, RT1.2, SW1.2, U1.2 (GND), U2.2 (GND), U3.1 (PGND), U3.9 (AGND), U4.5 (SGND), U4.9 (SGND), U4.14 (PGND), U4.15 (EP), U5.1 (PGND), U5.9 (AGND), U6.2 (GND), U7.2 (GND), U10.2 (VEE), U12.2 (GND), U20.4 (AGND), U20.5 (PGND), U21.5 (OVP), U21.8 (RTN), U21.9 (GND), U21.17 (PAD), U22.4 (VSSK), U22.10 (VEE), U30.1 (OE), U30.3 (GND), U31.1 (OE), U31.3 (GND), U40.8 (VSSA), U40.23 (VSS), U40.35 (VSS), U40.47 (VSS), U41.2 (GND), U42.2 (GND), U43.2 (VSS), U45.2 (VEE), U50.11 (EPAD), U51.2 (GND), U52.2 (GND)
LAPTOP_BYP: R9.1, U40.20 (PB2)
LAPTOP_CC: C117.1, D40.2 (A), U43.1 (OUT)
LAPTOP_CC_D: D40.1 (K), R98.1
LAPTOP_EN: R46.1, U40.46 (PB9)
LAPTOP_ILIM: C118.1, R97.1, R99.2
LAPTOP_ILIM_N: C117.2, R97.2, U43.4 (IN-)
LAPTOP_ILIM_PWM: R99.1, U40.29 (PA8/TIM1_CH1)
LAPTOP_ISENSE: R47.1, U40.14 (PA4/ADC4), U42.1 (OUT)
LAPTOP_ISENSE_F: C119.1, R47.2, U43.3 (IN+)
LAPTOP_OK: R48.2, R49.1, U40.2 (PC13)
LAPTOP_OUT: C8.1, J3.1 (V+), Q7.5 (D), Q7.6 (D), Q7.7 (D), Q7.8 (D), R48.1, U7.4 (CATHODE)
LED_D0: R103.1, U30.4 (Y)
LED_D0R: D30.1 (DIN), R103.2
LED_D1: D30.3 (DOUT), D31.1 (DIN)
LED_D2: D31.3 (DOUT), R113.1
LED_D2W: J13.2 (DATA), R113.2
LED_DATA: U30.2 (A), U40.45 (PB8)
MCU_BOOT0: R111.1, SW2.1, U40.44 (BOOT0)
MCU_NRST: C136.1, SW1.1, U40.7 (NRST)
MCU_VDDA: C134.1, C135.1, R112.2, U40.9 (VDDA)
PACK_1: BT1.2 (-), BT2.1 (+)
PACK_2: BT2.2 (-), BT3.1 (+)
PACK_3: BT3.2 (-), BT4.1 (+)
PACK_F: C12.2, F1.2 (OUT), Q12.1 (S), Q12.2 (S), Q12.3 (S), U12.6 (ANODE)
PACK_P: BT1.1 (+), F1.1 (IN)
PACK_SENSE: C13.1, R86.2, R87.1, U40.12 (PA2/ADC2)
PASSIVE_DVDT: C60.1, U21.12 (dVdT)
PASSIVE_EN: R63.1, U21.7 (SHDN), U31.2 (A), U40.21 (PB10)
PASSIVE_EN5: Q13.4 (G), R66.1, U31.4 (Y)
PASSIVE_FLT: R62.2, U21.14 (FLT), U40.25 (PB12)
PASSIVE_ILIM: R60.1, U21.11 (ILIM)
PASSIVE_IMON: R61.1, U21.10 (IMON), U40.15 (PA5/ADC5)
PD_CC1: J1.A5 (CC1), U50.7 (CC1)
PD_CC2: J1.B5 (CC2), U50.6 (CC2)
PD_CFG1: R120.1, U50.9 (CFG1)
PD_DM: J1.A7 (D-), J1.B7 (D-2), U50.5 (DM)
PD_DP: J1.A6 (D+), J1.B6 (D+2), U50.4 (DP)
PD_PG: R121.2, U40.31 (PA10), U50.10 (PG)
PD_SCL: U40.38 (PA15), U50.2 (CFG2/SCL)
PD_SDA: U40.39 (PB3), U50.3 (CFG3/SDA)
PORT_N: C71.1, D71.2 (A), J5.7, J5.8, Q13.5 (D), Q13.6 (D), Q13.7 (D), Q13.8 (D), Q22.5 (D), U22.7 (OUT)
PORT_P: C62.1, D22.1 (K), D71.1 (K), J5.4, J5.5, Q23.2 (D), Q23.4 (D), R64.1, R70.1, U21.15 (OUT), U21.16 (OUT)
PORT_SENSE: C15.1, R64.2, R65.1, U40.17 (PA7/ADC7)
PORT_SW: Q24.1 (G), R29.1, U40.4 (PC15/OSC32_OUT)
PORT_SW_D: Q24.3 (D), R28.2
PORT_SW_G: D23.2 (A), Q23.1 (G), R27.2, R28.1
PSE_AGND: C70.1, C71.2, D70.1 (K), R70.2, U22.8 (AGND)
PSE_DUALPD: R76.1, U22.14 (DUALPD)
PSE_EN: R77.1, U40.26 (PB13)
PSE_GATE: Q22.4 (G), R71.2
PSE_GATE_DRV: R71.1, U22.6 (GATE)
PSE_LEGACY: R75.1, U22.13 (LEGACY)
PSE_MID: R74.1, U22.1 (MID)
PSE_ON: R79.2, U22.9 (LED), U40.22 (PB11)
PSE_PWRMODE: R73.1, U22.12 (PWRMODE)
PSE_RESET: R77.2, R78.1, U22.16 (RESET)
PSE_SENSE: Q22.1 (S), Q22.2 (S), Q22.3 (S), R72.1, U22.5 (SENSE)
SWCLK: J9.2, U40.37 (PA14/SWCLK)
SWDIO: J9.1, U40.34 (PA13/SWDIO)
TEMP_SENSE: C114.1, R107.2, RT1.1, U40.16 (PA6/ADC6/TIM3_CH1)
TEST_LOAD: Q11.1 (G), R100.1, U40.30 (PA9)
TEST_NODE: Q11.3 (D), R85.2, R88.2
U1_GATE: Q1.4 (G), U1.5 (GATE)
U1_VCAP: C1.1, U1.1 (VCAP)
U2_GATE: Q2.4 (G), U2.5 (GATE)
U2_VCAP: C2.1, U2.1 (VCAP)
U3_BOOT: C33.1, U3.7 (BOOT)
U3_FB: R30.2, R31.1, U3.5 (FB)
U3_SW: C33.2, L3.1, U3.8 (SW)
U3_VCC: C32.1, U3.6 (VCC)
U4_BST: C43.1, U4.12 (BST)
U4_EN: R46.2, R92.1, U4.3 (EN)
U4_FB: C49.2, R40.1, R41.2, R98.2, U4.4 (FB)
U4_HG: Q40.1 (G), U4.11 (HG)
U4_ILIM: R45.1, U4.8 (ILIM)
U4_LG: Q41.1 (G), U4.13 (LG)
U4_RON: R44.2, U4.7 (RON)
U4_SS: C48.1, U4.6 (SS)
U4_SW: C43.2, L4.1, Q40.3 (S), Q41.2 (D), R45.2, U4.10 (SW)
U4_VCC: C42.1, U4.1 (VCC)
U5_BOOT: C53.1, U5.7 (BOOT)
U5_FB: R50.2, R51.1, U5.5 (FB)
U5_SW: C53.2, L5.1, U5.8 (SW)
U5_VCC: C52.1, U5.6 (VCC)
U6_GATE: Q6.4 (G), U6.5 (GATE)
U6_VCAP: C6.1, U6.1 (VCAP)
U7_GATE: Q7.4 (G), U7.5 (GATE)
U7_VCAP: C7.1, U7.1 (VCAP)
U12_GATE: Q12.4 (G), U12.5 (GATE)
U12_VCAP: C12.1, U12.1 (VCAP)
UART_RX: J11.2, U40.43 (PB7)
UART_TX: J11.1, U40.42 (PB6)
USB_D+: U40.33 (PA12/USB_DP), U52.4 (I/O2_OUT)
USB_D-: U40.32 (PA11/USB_DM), U52.6 (I/O1_OUT)
USB_DIS: Q25.1 (G), R6.1, U40.41 (PB5)
USB_DM_CON: J12.A7 (D-), J12.B7 (D-2), U52.1 (I/O1)
USB_DP_CON: J12.A6 (D+), J12.B6 (D+2), U52.3 (I/O2)
USB_EN: Q25.3 (D), R5.2, U1.3 (EN)
USB_ISENSE: U40.13 (PA3/ADC3), U41.1 (OUT)
USB_VBUS: C143.1, J12.A4 (VBUS), J12.A9, J12.B4 (VBUS2), J12.B9, U52.5 (VBUS)
VIN: C4.1, C30.1, C31.1, C40.1, C41.1, C44.1, C90.1, C91.1, D24.1 (K), Q1.5 (D), Q1.6 (D), Q1.7 (D), Q1.8 (D), Q2.5 (D), Q2.6 (D), Q2.7 (D), Q2.8 (D), Q40.2 (D), Q44.1 (S), Q44.2 (S), Q44.3 (S), R7.1, R44.1, R90.1, U1.4 (CATHODE), U2.4 (CATHODE), U3.2 (VIN), U3.3 (EN), U4.2 (VIN)
VIN_DC: C2.2, C3.1, D2.1 (K), J2.1 (V+), Q2.1 (S), Q2.2 (S), Q2.3 (S), R94.1, U2.3 (EN), U2.6 (ANODE)
VIN_SENSE: C14.1, R90.2, R91.1, U10.4 (IN-), U40.11 (PA1/ADC1), U45.4 (IN-)
VIN_USB: C140.1, D1.1 (K), J1.A4B9 (VBUS), J1.B4A9 (VBUS), R93.1, U41.3 (IN+), U50.1 (VHV), U50.8 (VBUS)
VIN_USBS: C1.2, Q1.1 (S), Q1.2 (S), Q1.3 (S), R5.1, R93.2, U1.6 (ANODE), U41.4 (IN-)

Notes on the sheet:
STAGES 1-3 DONE: power tree, radio port, MCU. Stage 4 = the board. Port placement for the board: TOP edge = laptop side (J6 RJ45 laptop, J3 laptop DC out, the USB-C serial). RIGHT edge = power in (J1 PD trigger module, J2 DC jack). BOTTOM edge = radio (J5 RJ45 radio). D30 sits by the power inputs, 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
RADIO PORT: PORT_P = pins 4/5, PORT_N = pins 7/8 (Mode B). Unknown port: boost on, Q23 (PORT_SW) closed, PSE_EN: U22 probes the PD. Valid 802.3 signature within 700 ms: active, U22 powers PORT_N, 54 V on the port. No signature: PORT_SW open, PSE_EN off, PORT_P decays through R64, then PASSIVE_EN: U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
PSE: LTC4279 (SO-16) per datasheet Figure 13. PORT_P is its AGND supply through R70 10R; board GND is its VEE; Q22 (PSMN075-100MSEX, ADI's recommended FET) switches PORT_N through R72 0.1R. PWRMODE 3.32k = Type 2, 25.5 W. RESET pulled down: port off until the MCU raises PSE_EN. PSE_ON is low while 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
INPUTS: 14-26 V from a USB-C PD trigger module (J1) or a DC jack (J2), ideal-diode ORed. Highest wins. The USB-C PD sink (CH224A) is on the board now, no trigger module. Standard supply is a 24 V 5 A brick; the Toughbook's own 15.6 V brick or a 19-20 V laptop brick also work. J2 and J3 are both 5.5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
RAILS: +12V is the backed-up rail (radio passive output, 54 V PSE boost, 5 V, 3.3 V). LAPTOP_OUT is off the raw input so it sheds itself on a dropout. Bucks are LMR33630 at 400 kHz per datasheet Table 9-1; the laptop one is set to 15.6 V (the Toughbook brick voltage) and runs in dropout on that bri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
BACKUP: 4x CR123A (12 V nominal, no boost, no BMS). Q8 closes when Vin < 16 V, opens when it returns. R84 hysteresis. Firmware (stage 3) opens it after 2 s of no radio load or 5 min, by pulling BK_ON low through a diode-OR at R81 (TBD stage 3). Self-test: TEST_LOAD high for 200 ms, read PACK_SENSE;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
ASSEMBLY: all SMT except connectors and cell holders, so the BOM is production-ready as is. First units hand-built: every IC is SO / SOT-23 / HTSSOP, passives 0805+, exposed pads (3 bucks, eFuse, FETs) get thermal vias for hot air. No leadless packages.
OPEN: Passive-mode radio draw (assumed 10 W) and the PD brick's dropout time still need measuring. Laptop rail is off at reset (LAPTOP_EN) and constant-current limited (LAPTOP_ILIM): firmware sets the limit to allocation minus the box draw so a shared charger never trips; what the Toughbook does wh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
MCU: STM32F072CBT6 (128 KB), no radio. ADC: PA0 VIN_SENSE, PA1 PACK_SENSE (1M/150k), PA2 PASSIVE_IMON, PA3 TEMP_SENSE, PA4 FAN_SENSE, ADC5 USB_ISENSE (2 V = 5 A), ADC7 DCIN_SENSE, ADC8 PORT_SENSE (1M/51k, 56 V = 2.72 V), ADC9 LAPTOP_ISENSE (0.4 V = 1 A). Out: PB2 LAPTOP_EN (off at reset), PA9 LAPTO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

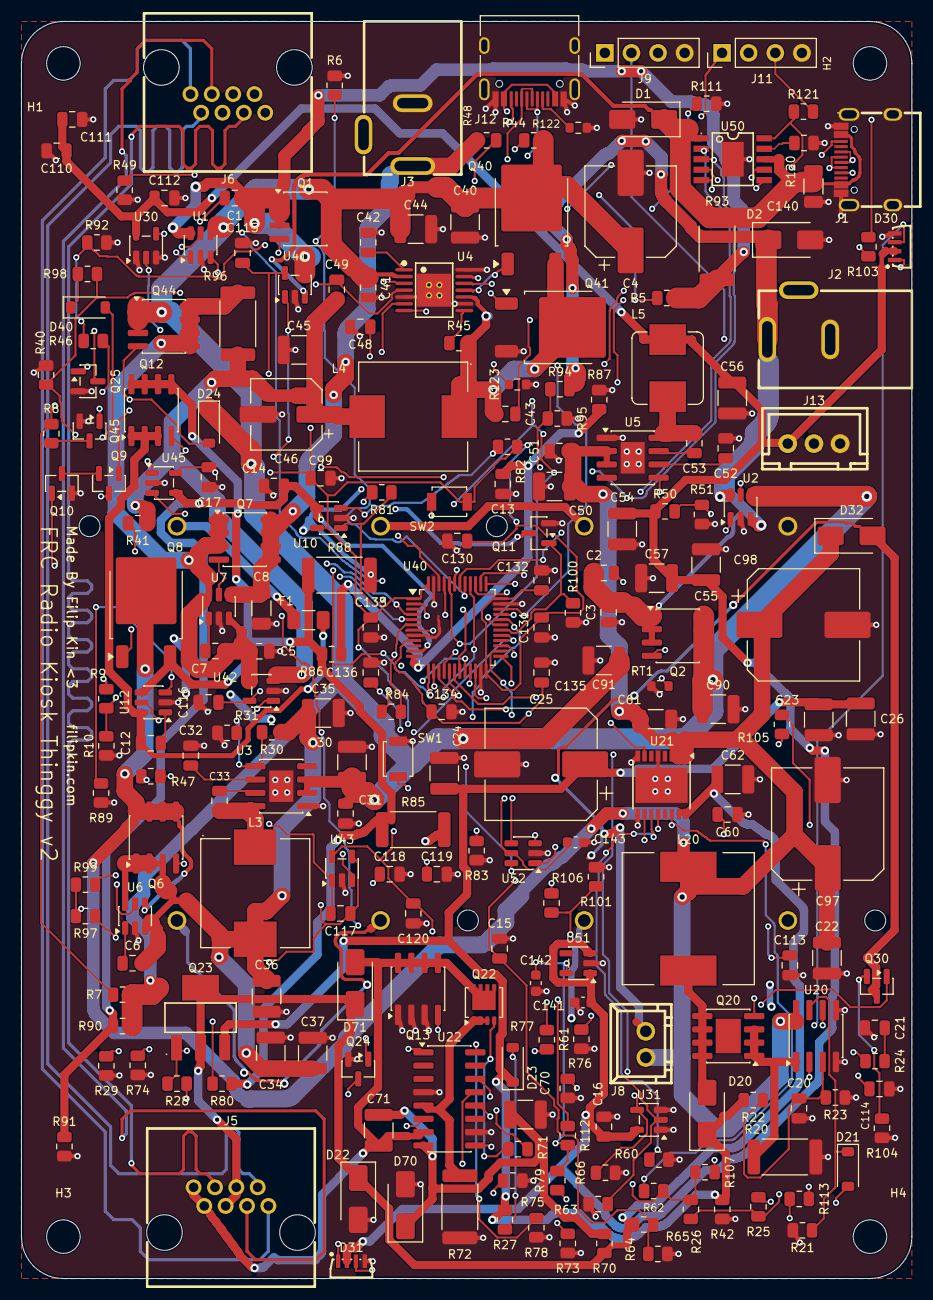
[picture p16: board board.kicad_pcb from above]

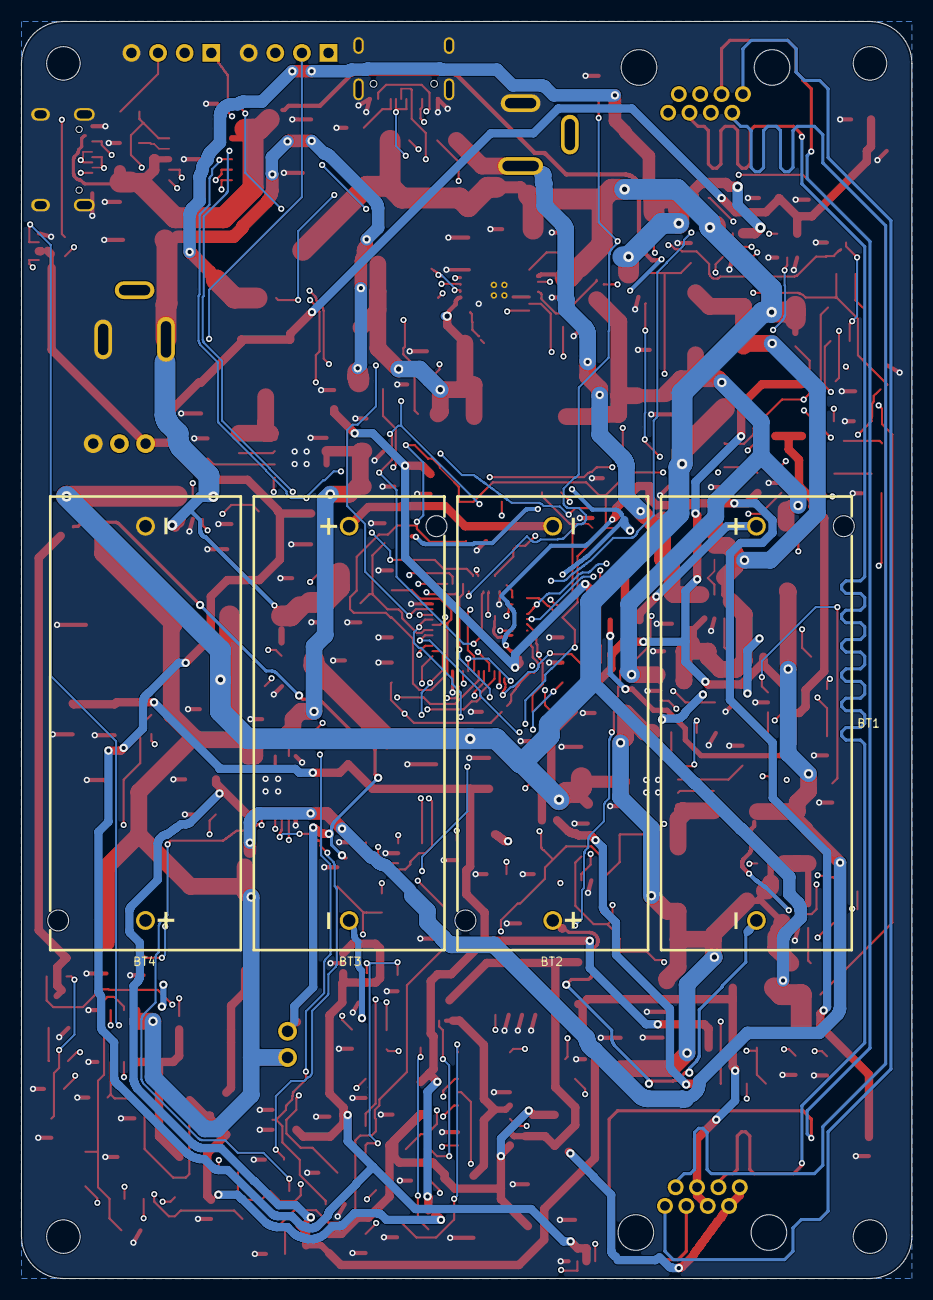
[picture p17: board board.kicad_pcb from below]

Board: 4 copper layers, 85.0 x 120.0 mm, 239 parts (4 on the bottom side), 145 nets.

Other parts of the board:
H1, H2, H3, H4: M3 mount; MountingHole_3.2mm_M3
