Filip-Kin/frc-radio-kiosk/Radio_Kiosk_v2d/firmware/src/main.cpp

// FRC radio kiosk v2 firmware. STM32F072CBT6, Arduino (STM32duino).
//
// What it does, in order of importance:
//   1. Radio port: probe for 802.3at first (boost on, port switch closed, PSE
//      detecting), fall back to passive 12 V through the eFuse. Never both.
//      A board built without the active parts (U22/U20/Q23 unpopulated) is
//      noticed at the first probe and skipped from then on.
//   2. Battery: the comparator closes the pack FET by itself once firmware has
//      armed it (BK_EN); this code drops the arm after 5 s of no radio load or
//      5 min, and runs the loaded self-test at boot and every 24 h.
//   3. Laptop rail: on when the source can afford it, constant-current limited
//      to (allocation - measured box draw + 10 %) so a shared GaN charger never
//      trips, derated by temperature, cut on a shorted jack. On a 16 V brick
//      with no radio on the port the buck is bypassed (Q44) so the Toughbook
//      sees its own brick voltage.
//   4. USB-C input dropped while the DC jack is live (USB_DIS).
//   5. Fan, LEDs, and a JSON status line on USB and UART every 500 ms.
//   6. Independent watchdog, 2 s.
//
// Pin map matches the schematic notes in build-radio-kiosk.ts (2026-09-24).
#include <Arduino.h>
#include <Adafruit_NeoPixel.h>
#include <ArduinoJson.h>
#include <IWatchdog.h>
#include "stm32f0xx.h"

// Flash is 128 kB, but STM32duino's HAL I2C and HardwareTimer are 27 kB, so
// the I2C to the CH224A is bit-banged and the two PWMs talk to the timer
// registers directly.

// #region pins
static const int PIN_VIN_SENSE = PA1;      // 33k/4.7k: 1.65 V = 13.2 V
static const int PIN_PACK_SENSE = PA2;     // 1M/150k after the pack ideal diode
static const int PIN_PASSIVE_IMON = PA5;   // TPS26600 IMON into 10k: 0.78 V/A
static const int PIN_TEMP_SENSE = PA6;     // 10k / NTC 10k B3380 to GND
static const int PIN_FAN_SENSE = PB0;      // 1R shunt through 10k/10n
static const int PIN_USB_ISENSE = PA3;     // INA180A1 x20 on 20 mR: 0.4 V/A
static const int PIN_DCIN_SENSE = PB1;     // 33k/4.7k on the DC jack
static const int PIN_PORT_SENSE = PA7;     // 1M/51k on PORT_P: 20.6 V per volt
static const int PIN_LAPTOP_ISENSE = PA4;  // INA180A1 x20 on 20 mR: 0.4 V/A

static const int PIN_LAPTOP_EN = PB9;
static const int PIN_TEST_LOAD = PA9;
static const int PIN_BOOST_SD = PB14;      // high = boost off (pulled up at reset)
static const int PIN_PASSIVE_EN = PB10;
static const int PIN_PSE_EN = PB13;
static const int PIN_PORT_SW = PC15;       // high closes Q23: boost output onto the port
static const int PIN_USB_DIS = PB5;        // high drops the USB-C input path
static const int PIN_FAN_PWM = PB4;        // TIM3_CH1
static const int PIN_LED_DATA = PB8;       // through the AHCT buffer to two WS2812B-4020
static const int PIN_BK_EN = PF0;         // high arms the pack switch (and its ideal diode)
static const int PIN_LAPTOP_ILIM = PA8;    // TIM1_CH2, filtered: 0.4 V per amp of limit
static const int PIN_LAPTOP_BYP = PB2;    // high lets Q44 bypass the buck below ~17.6 V in

static const int PIN_BK_ON = PF1;          // comparator: high = on battery
static const int PIN_PASSIVE_FLT = PB12;    // eFuse fault, active low
static const int PIN_PSE_ON = PB11;         // LTC4279 LED pin, low = port powered
static const int PIN_PD_PG = PA10;          // CH224A PG, low = 20 V granted
static const int PIN_LAPTOP_OK = PC13;     // 47k/10k on LAPTOP_OUT: high above ~5.6 V

// J11 is USART1 on PB6/PB7. STM32duino defaults USART1 to PA9/PA10, which are
// LAPTOP_ILIM and BK_EN, so the pins are set before Serial1.begin().
static const int PIN_UART_TX = PB6;
static const int PIN_UART_RX = PB7;

// #region scaling
static const float ADC_V = 3.3f / 4095.0f;
static const float DIV_HV = 37.7f / 4.7f;       // 33k / 4.7k on VIN and DCIN
static const float DIV_PACK = 1150.0f / 150.0f; // 1M / 150k
static const float DIV_PORT = 1051.0f / 51.0f;  // 1M / 51k
static const float LAPTOP_V_PER_A = 0.4f;       // INA180A1 on 20 mR, sense and setpoint alike
static const float LAPTOP_MAX_A = 4.5f;         // the rail's rating; the LM3150 valley limit is just above
static float vinV = 0, packV = 0, dcinV = 0, portV = 0, passiveA = 0, usbA = 0, laptopA = 0, tempC = 25, fanRipple = 0;
static bool tempFault = false;   // NTC open or shorted; tempC holds its last good value

static float readV(int pin) { return analogRead(pin) * ADC_V; }

static void sampleAnalog() {
  vinV = readV(PIN_VIN_SENSE) * DIV_HV;
  packV = readV(PIN_PACK_SENSE) * DIV_PACK;
  dcinV = readV(PIN_DCIN_SENSE) * DIV_HV;
  portV = readV(PIN_PORT_SENSE) * DIV_PORT;
  passiveA = readV(PIN_PASSIVE_IMON) / 0.78f;
  usbA = readV(PIN_USB_ISENSE) / 0.4f;
  laptopA = readV(PIN_LAPTOP_ISENSE) / LAPTOP_V_PER_A;
  float vt = readV(PIN_TEMP_SENSE);
  tempFault = vt < 0.01f || vt > 3.29f;
  if (!tempFault) {
    float r = 10000.0f * vt / (3.3f - vt);
    float invT = 1.0f / 298.15f + logf(r / 10000.0f) / 3380.0f;
    tempC = 1.0f / invT - 273.15f;
  }
  // A spinning fan puts commutation ripple on its shunt; a stalled one is flat.
  float lo = 9, hi = 0;
  for (int i = 0; i < 32; i++) {
    float v = readV(PIN_FAN_SENSE);
    lo = min(lo, v); hi = max(hi, v);
    delayMicroseconds(200);
  }
  fanRipple = hi - lo;
}

// #region radio port state machine
// IDLE -> PROBE (boost up, Q23 closed, PSE detecting, 700 ms) -> ACTIVE
//                                                   \-> TEARDOWN -> PASSIVE
// A backfeeding radio (robot battery on the port) shows as voltage on an idle
// port, a PSE fault in ACTIVE, or the eFuse breaker in PASSIVE.
enum PortMode { PORT_IDLE, PORT_PROBE, PORT_TEARDOWN, PORT_ACTIVE, PORT_PASSIVE, PORT_FAULT };
static PortMode port = PORT_IDLE;
static uint32_t portSince = 0;
static int probeStep = 0;
static bool backfeed = false;
static bool activeAvail = true;       // false once a probe found no boost (parts not fitted)
static bool activeEnabled = true;     // serial "active off" clears it
static const char *portNote = "";

static void portAllOff() {
  digitalWrite(PIN_PSE_EN, LOW);
  digitalWrite(PIN_PORT_SW, LOW);
  digitalWrite(PIN_BOOST_SD, HIGH);
  digitalWrite(PIN_PASSIVE_EN, LOW);
}

static bool pseOn() { return digitalRead(PIN_PSE_ON) == LOW; }
static bool passiveFault() { return digitalRead(PIN_PASSIVE_FLT) == LOW; }

static void portGo(PortMode m, uint32_t now, const char *note = "") {
  port = m; portSince = now; probeStep = 0; portNote = note;
}

static void portTick(uint32_t now) {
  uint32_t t = now - portSince;
  switch (port) {
    case PORT_IDLE:
      // Everything off. Voltage on the port with nothing driving it is a radio
      // fed from the other side: do not power it.
      backfeed = portV > 0.15f;
      if (backfeed) { portNote = "backfeed on idle port"; break; }
      if (t < 300) break;   // let the port settle between windows
      if (activeAvail && activeEnabled) { digitalWrite(PIN_BOOST_SD, LOW); portGo(PORT_PROBE, now); }
      else { digitalWrite(PIN_PASSIVE_EN, HIGH); portGo(PORT_PASSIVE, now); }
      break;
    case PORT_PROBE:
      // 0: boost soft-start (4 ms typ). 1: port switch closed, wait for the
      // 54 V to reach the port. 2: PSE detecting; a valid signature powers the
      // port inside 570 ms worst case.
      if (probeStep == 0 && t > 10) { digitalWrite(PIN_PORT_SW, HIGH); probeStep = 1; }
      else if (probeStep == 1) {
        if (portV > 45.0f) { digitalWrite(PIN_PSE_EN, HIGH); probeStep = 2; portSince = now; }
        else if (t > 200) {
          // No boost voltage: the active parts are not on this board.
          activeAvail = false;
          portAllOff();
          portGo(PORT_TEARDOWN, now, "no boost: active PoE not fitted");
        }
      } else if (probeStep == 2) {
        if (pseOn()) portGo(PORT_ACTIVE, now, "802.3at");
        else if (t > 700) { portAllOff(); portGo(PORT_TEARDOWN, now); }
      }
      break;
    case PORT_TEARDOWN:
      // The LTC4279's own supply pulls PORT_P down once Q23 is open (tau ~26 ms).
      if (portV < 0.15f || t > 400) { digitalWrite(PIN_PASSIVE_EN, HIGH); portGo(PORT_PASSIVE, now, "passive"); }
      break;
    case PORT_ACTIVE: {
      // PSE_ON must stay high for 500 ms before the port counts as unpowered,
      // so noise on the pin cannot drop the radio. The PSE's own overcurrent
      // (a robot battery on the port) also shows up here.
      static uint32_t offSince = 0;
      if (pseOn()) offSince = 0;
      else if (!offSince) offSince = now;
      if (offSince && now - offSince > 500) { offSince = 0; portAllOff(); portGo(PORT_IDLE, now, "port dropped"); }
      break;
    }
    case PORT_PASSIVE: {
      // The eFuse is a circuit breaker: over 2.1 A it opens itself and pulls
      // FLT. A robot rail above 12 V trips its reverse comparator the same way.
      if (passiveFault()) { backfeed = true; portAllOff(); portGo(PORT_FAULT, now, "eFuse fault"); break; }
      static uint32_t noLoadSince = 0;
      if (passiveA < 0.05f) { if (!noLoadSince) noLoadSince = now; }
      else noLoadSince = 0;
      // Nothing drawn for 10 s: the radio is gone, go back and look again.
      if (noLoadSince && now - noLoadSince > 10000 && t > 15000) { noLoadSince = 0; portAllOff(); portGo(PORT_IDLE, now); }
      break;
    }
    case PORT_FAULT:
      if (t > 2000) { backfeed = false; portGo(PORT_IDLE, now); }
      break;
  }
}

static bool radioLoaded() {
  return (port == PORT_ACTIVE && pseOn()) || (port == PORT_PASSIVE && passiveA > 0.05f);
}
// A radio is present, or the port is still being worked out: no bypass then.
static bool portBusy() { return port != PORT_IDLE && !(port == PORT_PASSIVE && passiveA < 0.05f); }

// #region battery
static bool onBattery = false;
static uint32_t batterySince = 0, noLoadSince = 0;
static bool batteryKilled = false;
static uint32_t batteryCapMs = 300000;   // 5 min hard cap, settable over serial
static bool packOk = true;
static float packLoadedV = 0;
static uint32_t lastSelfTest = 0;

static void batteryTick(uint32_t now) {
  bool bk = digitalRead(PIN_BK_ON) == HIGH;
  if (bk && !onBattery) { batterySince = now; noLoadSince = 0; }
  onBattery = bk;
  // Off battery: keep the switch armed so the comparator can close it the
  // instant the input goes.
  if (!bk) { batteryKilled = false; digitalWrite(PIN_BK_EN, HIGH); return; }
  if (batteryKilled) return;
  if (!radioLoaded()) { if (!noLoadSince) noLoadSince = now; } else noLoadSince = 0;
  // 5 s is longer than a full probe window, so a port restart on battery does
  // not drop the pack before the radio is powered again.
  bool cut = (noLoadSince && now - noLoadSince > 5000) || (now - batterySince > batteryCapMs);
  if (cut) { digitalWrite(PIN_BK_EN, LOW); batteryKilled = true; }
}

// Two 200 ms pulses into the 12R dump; the first wakes lithium primaries from
// passivation, the second is the reading. Four CR123A under a 1 A pulse:
// below 8.8 V loaded, replace the set.
static void selfTest(uint32_t now) {
  if (onBattery) return;
  for (int i = 0; i < 2; i++) {
    digitalWrite(PIN_TEST_LOAD, HIGH);
    delay(180);
    packLoadedV = readV(PIN_PACK_SENSE) * DIV_PACK;
    delay(20);
    digitalWrite(PIN_TEST_LOAD, LOW);
    delay(300);
  }
  packOk = packLoadedV > 8.8f;
  lastSelfTest = now;
}

// #region PD sink (CH224A over I2C)
struct PdInfo { bool ok; uint8_t addr; uint8_t status; uint8_t currentReg; float maxA; };
static PdInfo pd = { false, 0x22, 0, 0, 0 };

// #region bit-banged I2C on PA15 (SCL) / PB3 (SDA), ~50 kHz, open-drain
// The CH224A is powered from the USB-C input. With no USB in, the pins stay
// plain inputs: pull-ups into an unpowered part would feed it through its
// protection diodes.
static const int PIN_SCL = PA15, PIN_SDA = PB3;
static inline void sclHi() { pinMode(PIN_SCL, INPUT_PULLUP); }
static inline void sclLo() { pinMode(PIN_SCL, OUTPUT); digitalWrite(PIN_SCL, LOW); }
static inline void sdaHi() { pinMode(PIN_SDA, INPUT_PULLUP); }
static inline void sdaLo() { pinMode(PIN_SDA, OUTPUT); digitalWrite(PIN_SDA, LOW); }
static inline void i2cRelease() { pinMode(PIN_SCL, INPUT); pinMode(PIN_SDA, INPUT); }
static inline void i2cDelay() { delayMicroseconds(5); }
static void i2cStart() { sdaHi(); sclHi(); i2cDelay(); sdaLo(); i2cDelay(); sclLo(); i2cDelay(); }
static void i2cStop() { sdaLo(); i2cDelay(); sclHi(); i2cDelay(); sdaHi(); i2cDelay(); }
static bool i2cWrite(uint8_t b) {
  for (int i = 7; i >= 0; i--) { if (b & (1 << i)) sdaHi(); else sdaLo(); i2cDelay(); sclHi(); i2cDelay(); sclLo(); }
  sdaHi(); i2cDelay(); sclHi(); i2cDelay();
  bool ack = digitalRead(PIN_SDA) == LOW;
  sclLo(); i2cDelay();
  return ack;
}
static uint8_t i2cRead(bool ack) {
  uint8_t v = 0;
  sdaHi();
  for (int i = 0; i < 8; i++) { sclHi(); i2cDelay(); v = (v << 1) | (digitalRead(PIN_SDA) == HIGH ? 1 : 0); sclLo(); i2cDelay(); }
  if (ack) sdaLo(); else sdaHi();
  i2cDelay(); sclHi(); i2cDelay(); sclLo(); sdaHi(); i2cDelay();
  return v;
}
static bool ch224Read(uint8_t addr, uint8_t reg, uint8_t &val) {
  i2cStart();
  bool ok = i2cWrite(addr << 1) && i2cWrite(reg);
  if (ok) { i2cStart(); ok = i2cWrite((addr << 1) | 1); if (ok) val = i2cRead(false); }
  i2cStop();
  return ok;
}

static bool usbPresent() { return digitalRead(PIN_PD_PG) == LOW; }

static void pdTick() {
  if (!usbPresent()) { pd.ok = false; pd.maxA = 0; i2cRelease(); return; }
  uint8_t st = 0, cur = 0;
  // The CH224A answers at 0x22 or 0x23 depending on the part; try the other one
  // when the first does not ACK.
  bool ok = ch224Read(pd.addr, 0x09, st) && ch224Read(pd.addr, 0x50, cur);
  if (!ok) { pd.addr ^= 0x01; ok = ch224Read(pd.addr, 0x09, st) && ch224Read(pd.addr, 0x50, cur); }
  pd.ok = ok;
  pd.status = st;
  pd.currentReg = cur;
  // The datasheet calls 0x50 "maximum current available under the current PD
  // gear". Its unit is not stated in the text we have; 50 mA per count is the
  // usual PD granularity. TODO: confirm on hardware against a known charger.
  pd.maxA = pd.ok ? cur * 0.05f : 0;
  i2cRelease();
}

// #region PWM on the timer registers
// Rev C: TIM3_CH1 on PB4 (AF1) for the fan at 25 kHz; TIM1_CH1 on PA8 (AF2)
// for the laptop current-limit setpoint at 20 kHz. Register level, no HAL.
static void pwmInit() {
  RCC->AHBENR |= RCC_AHBENR_GPIOAEN | RCC_AHBENR_GPIOBEN;
  RCC->APB1ENR |= RCC_APB1ENR_TIM3EN;
  RCC->APB2ENR |= RCC_APB2ENR_TIM1EN;
  // PB4 -> AF1 (TIM3_CH1), PA8 -> AF2 (TIM1_CH1)
  GPIOB->MODER = (GPIOB->MODER & ~(3u << (4 * 2))) | (2u << (4 * 2));
  GPIOB->AFR[0] = (GPIOB->AFR[0] & ~(0xFu << (4 * 4))) | (1u << (4 * 4));
  GPIOA->MODER = (GPIOA->MODER & ~(3u << (8 * 2))) | (2u << (8 * 2));
  GPIOA->AFR[1] = (GPIOA->AFR[1] & ~(0xFu << ((8 - 8) * 4))) | (2u << ((8 - 8) * 4));
  TIM3->PSC = 0; TIM3->ARR = 1919; TIM3->CCR1 = 0;            // 48 MHz / 1920 = 25 kHz
  TIM3->CCMR1 = (6u << 4) | TIM_CCMR1_OC1PE;                    // PWM mode 1
  TIM3->CCER = TIM_CCER_CC1E; TIM3->CR1 = TIM_CR1_ARPE | TIM_CR1_CEN;
  TIM1->PSC = 0; TIM1->ARR = 2399; TIM1->CCR1 = 0;            // 20 kHz
  TIM1->CCMR1 = (6u << 4) | TIM_CCMR1_OC1PE;
  TIM1->CCER = TIM_CCER_CC1E; TIM1->BDTR = TIM_BDTR_MOE; TIM1->CR1 = TIM_CR1_ARPE | TIM_CR1_CEN;
}
static void fanPwm(int percent) { TIM3->CCR1 = (uint32_t)(constrain(percent, 0, 100) * 1919L / 100); }
static void laptopLimitPwm(float volts) { TIM1->CCR1 = (uint32_t)(constrain(volts / 3.3f, 0.0f, 1.0f) * 2399); }

// USB runs from HSI48; the clock recovery system trims it to the host's SOF
// so the CDC link holds without a crystal.
static void crsInit() {
  RCC->APB1ENR |= RCC_APB1ENR_CRSEN;
  CRS->CFGR = CRS_CFGR_SYNCSRC_1 | (0x22u << CRS_CFGR_FELIM_Pos) | (48000u - 1u);   // USB SOF, 1 kHz
  CRS->CR |= CRS_CR_AUTOTRIMEN | CRS_CR_CEN;
}

// #region laptop rail
static bool laptopWanted = true;      // serial "laptop off" clears it
static float laptopLimitA = LAPTOP_MAX_A;
static float laptopLimitManual = 0;   // >0 overrides the computed limit
static bool laptopOn = false;
static bool laptopBypass = false;
static int bypassMode = 0;            // 0 auto, 1 forced off, -1 never (serial)
static bool laptopFault = false;      // jack shorted or rail collapsed
static uint32_t laptopFaultSince = 0, laptopBadSince = 0;
static float boxA = 0;                // measured draw of everything but the laptop, at 20 V

static void laptopTick(uint32_t now) {
  bool dcIn = dcinV > 13.5f;
  bool usbIn = usbPresent();
  bool sourceOk = vinV > 13.5f && (dcIn || usbIn);
  float limit = LAPTOP_MAX_A;
  if (!dcIn && usbIn) {
    // Budget: the charger's allocation minus what the box draws right now,
    // plus 10 %. The box draw is the USB input minus the laptop's share of it
    // (15.9 V out, ~90 % efficient), so nothing is held back for a radio that
    // is not plugged in.
    float allocA = pd.ok && pd.maxA > 0.5f ? pd.maxA : 3.25f;   // 65 W if we cannot read it
    float laptopInA = laptopA * 15.9f / 20.0f / 0.9f;
    boxA = max(0.1f, usbA - laptopInA);
    limit = max(0.0f, (allocA - boxA * 1.1f) * 20.0f / 15.9f * 0.9f);
  }
  // A dead NTC leaves tempC stale; the fan covers it, the laptop keeps running.
  if (!tempFault) {
    if (tempC > 85) limit = 0;
    else if (tempC > 70) limit *= 0.5f;
  }
  if (laptopLimitManual > 0) limit = min(limit, laptopLimitManual);
  laptopLimitA = min(limit, LAPTOP_MAX_A);

  // Shorted jack: the CC loop would hold the buck in a happy 4.5 A short
  // forever, so watch the jack voltage. 200 ms low while enabled = fault,
  // retry after 5 s.
  bool jackOk = digitalRead(PIN_LAPTOP_OK) == HIGH;
  if ((laptopOn || laptopBypass) && !jackOk) { if (!laptopBadSince) laptopBadSince = now; }
  else laptopBadSince = 0;
  if (laptopBadSince && now - laptopBadSince > 200) { laptopFault = true; laptopFaultSince = now; laptopBadSince = 0; }
  if (laptopFault && now - laptopFaultSince > 5000) laptopFault = false;

  bool want = laptopWanted && sourceOk && !onBattery && !laptopFault && laptopLimitA > 0.2f;

  // 16 V brick (the Toughbook's own): no buck can make 15.9 V from it, so
  // pass the brick through while no radio is on the port. The comparator on
  // the board refuses above ~17.6 V whatever this pin says. Hysteresis so a
  // sagging 20 V source does not flap.
  bool lowBrick = laptopBypass ? vinV < 17.4f : vinV < 17.0f;
  bool bypass = want && dcIn && lowBrick && !portBusy() && bypassMode == 0;
  if (bypass && !laptopBypass) { digitalWrite(PIN_LAPTOP_EN, LOW); delay(2); }
  laptopBypass = bypass;
  laptopOn = want && !bypass;
  digitalWrite(PIN_LAPTOP_BYP, laptopBypass ? HIGH : LOW);
  digitalWrite(PIN_LAPTOP_EN, laptopOn ? HIGH : LOW);
  laptopLimitPwm(laptopLimitA * LAPTOP_V_PER_A);
}

// #region inputs
// With the DC jack live the USB-C path is dropped so the two sources never
// share the load through the ideal diodes. Released as soon as the jack goes.
static bool usbDisabled = false;
static void inputTick() {
  bool dcIn = dcinV > 13.5f;
  usbDisabled = dcIn;
  digitalWrite(PIN_USB_DIS, usbDisabled ? HIGH : LOW);
}

// #region fan
static int fanDuty = 0;
static bool fanStalled = false;
static void fanTick() {
  int duty = 0;
  if (onBattery) duty = 0;
  else if (tempFault) duty = 100;
  else if (tempC > 40) duty = (int)constrain((tempC - 40.0f) / 30.0f * 60.0f + 40.0f, 40.0f, 100.0f);
  fanDuty = duty;
  fanPwm(duty);
  fanStalled = duty > 30 && fanRipple < 0.02f;
}

// #region LEDs
// Two side emitters on the board, then J13 for two more on the lid (WS2812B
// carriers on a wire). The lid pair mirrors the side pair.
static const int LED_COUNT = 4;
Adafruit_NeoPixel leds(LED_COUNT, PIN_LED_DATA, NEO_GRB + NEO_KHZ800);
static const uint32_t OFF = 0, RED = 0x400000, GREEN = 0x004000, BLUE = 0x000040, AMBER = 0x402000, WHITE = 0x303030;

static void ledTick(uint32_t now) {
  bool blink = (now / 400) & 1;
  bool fast = (now / 150) & 1;
  // D30, power side.
  uint32_t p;
  if (!packOk) p = fast ? RED : BLUE;
  else if (!tempFault && tempC > 85) p = blink ? RED : OFF;
  else if (laptopFault) p = fast ? RED : AMBER;
  else if (onBattery) p = blink ? AMBER : OFF;
  else if (vinV > 18) p = GREEN;
  else if (vinV > 13.5f) p = AMBER;
  else if (vinV > 4) p = RED;
  else p = OFF;
  // D31, radio side.
  uint32_t r;
  if (backfeed) r = fast ? RED : OFF;
  else if (port == PORT_ACTIVE) r = BLUE;
  else if (port == PORT_PASSIVE && passiveA > 0.05f) r = GREEN;
  else if (port == PORT_PROBE || port == PORT_TEARDOWN) r = blink ? WHITE : OFF;
  else r = RED;
  if (onBattery && !batteryKilled) r = blink ? r : OFF;
  leds.setPixelColor(0, p);
  leds.setPixelColor(1, r);
  leds.setPixelColor(2, p);   // lid, power side
  leds.setPixelColor(3, r);   // lid, radio side
  leds.show();
}

// #region serial
static bool wdtReset = false;   // last reset came from the watchdog

static const char *modeName() {
  switch (port) {
    case PORT_IDLE: return "idle"; case PORT_PROBE: return "probe"; case PORT_TEARDOWN: return "teardown";
    case PORT_ACTIVE: return "active"; case PORT_PASSIVE: return "passive"; default: return "fault";
  }
}

static void statusLine(Stream &s) {
  JsonDocument doc;
  doc["t"] = millis();
  doc["vin"] = serialized(String(vinV, 2));
  doc["dcin"] = serialized(String(dcinV, 2));
  doc["usb_dis"] = usbDisabled;
  doc["pack"] = serialized(String(packV, 2));
  doc["pack_loaded"] = serialized(String(packLoadedV, 2));
  doc["pack_ok"] = packOk;
  doc["battery"] = onBattery;
  doc["mode"] = modeName();
  doc["port_note"] = portNote;
  doc["port_v"] = serialized(String(portV, 2));
  doc["active_avail"] = activeAvail;
  doc["passive_a"] = serialized(String(passiveA, 3));
  doc["backfeed"] = backfeed;
  doc["usb_a"] = serialized(String(usbA, 3));
  doc["box_a"] = serialized(String(boxA, 3));
  doc["pd_ok"] = pd.ok;
  doc["pd_status"] = pd.status;
  doc["pd_max_a"] = serialized(String(pd.maxA, 2));
  doc["laptop"] = laptopOn;
  doc["laptop_bypass"] = laptopBypass;
  doc["laptop_fault"] = laptopFault;
  doc["laptop_a"] = serialized(String(laptopA, 3));
  doc["laptop_limit_a"] = serialized(String(laptopLimitA, 2));
  doc["temp_c"] = serialized(String(tempC, 1));
  doc["temp_fault"] = tempFault;
  doc["fan"] = fanDuty;
  doc["fan_stalled"] = fanStalled;
  doc["wdt_reset"] = wdtReset;
  serializeJson(doc, s);
  s.println();
}

static void command(char *line, Stream &s) {
  if (!strcmp(line, "laptop on")) laptopWanted = true;
  else if (!strcmp(line, "laptop off")) laptopWanted = false;
  else if (!strncmp(line, "limit ", 6)) laptopLimitManual = atof(line + 6);
  else if (!strcmp(line, "bypass auto")) bypassMode = 0;
  else if (!strcmp(line, "bypass off")) bypassMode = 1;
  else if (!strcmp(line, "active on")) { activeEnabled = true; activeAvail = true; }
  else if (!strcmp(line, "active off")) activeEnabled = false;
  else if (!strncmp(line, "cap ", 4)) batteryCapMs = (uint32_t)atol(line + 4) * 1000UL;
  else if (!strcmp(line, "test")) selfTest(millis());
  else if (!strcmp(line, "redetect")) { portAllOff(); portGo(PORT_IDLE, millis(), "redetect"); }
  else if (!strcmp(line, "help")) s.println("laptop on|off, limit <A>, bypass auto|off, active on|off, cap <s>, test, redetect");
  else { s.print("? "); s.println(line); return; }
  s.println("ok");
}

struct LineBuf { char b[64]; uint8_t n; };
static void pollSerial(Stream &s, LineBuf &buf) {
  while (s.available()) {
    char c = s.read();
    if (c == '\n' || c == '\r') { if (buf.n) { buf.b[buf.n] = 0; command(buf.b, s); } buf.n = 0; }
    else if (buf.n < sizeof(buf.b) - 1) buf.b[buf.n++] = c;
  }
}

// #region setup / loop
static LineBuf usbBuf = {{0}, 0}, uartBuf = {{0}, 0};

void setup() {
  // Everything off before anything is measured.
  pinMode(PIN_BOOST_SD, OUTPUT); digitalWrite(PIN_BOOST_SD, HIGH);
  pinMode(PIN_PSE_EN, OUTPUT); digitalWrite(PIN_PSE_EN, LOW);
  pinMode(PIN_PORT_SW, OUTPUT); digitalWrite(PIN_PORT_SW, LOW);
  pinMode(PIN_PASSIVE_EN, OUTPUT); digitalWrite(PIN_PASSIVE_EN, LOW);
  pinMode(PIN_LAPTOP_EN, OUTPUT); digitalWrite(PIN_LAPTOP_EN, LOW);
  pinMode(PIN_LAPTOP_BYP, OUTPUT); digitalWrite(PIN_LAPTOP_BYP, LOW);
  pinMode(PIN_USB_DIS, OUTPUT); digitalWrite(PIN_USB_DIS, LOW);
  pinMode(PIN_TEST_LOAD, OUTPUT); digitalWrite(PIN_TEST_LOAD, LOW);
  // Arm the pack switch: the comparator does the rest if the input goes.
  pinMode(PIN_BK_EN, OUTPUT); digitalWrite(PIN_BK_EN, HIGH);
  pwmInit();
  crsInit();
  pinMode(PIN_BK_ON, INPUT);
  pinMode(PIN_PASSIVE_FLT, INPUT_PULLUP);
  pinMode(PIN_PSE_ON, INPUT_PULLUP);   // reads "off" on a board without the PSE
  pinMode(PIN_PD_PG, INPUT_PULLUP);
  pinMode(PIN_LAPTOP_OK, INPUT);
  analogReadResolution(12);

  Serial.begin(115200);   // USB CDC
  Serial1.setRx(PIN_UART_RX);
  Serial1.setTx(PIN_UART_TX);
  Serial1.begin(115200);  // UART on J11
  i2cRelease();
  leds.begin(); leds.show();

  delay(200);
  sampleAnalog();
  selfTest(millis());

  // 2 s: longer than the ~1 s self-test, the longest block in loop().
  wdtReset = IWatchdog.isReset(true);
  IWatchdog.begin(2000000);
}

void loop() {
  static uint32_t lastFast = 0, lastSlow = 0;
  IWatchdog.reload();
  uint32_t now = millis();
  pollSerial(Serial, usbBuf);
  pollSerial(Serial1, uartBuf);
  if (now - lastFast >= 50) {
    lastFast = now;
    sampleAnalog();
    inputTick();
    portTick(now);
    batteryTick(now);
    laptopTick(now);
    ledTick(now);
  }
  if (now - lastSlow >= 500) {
    lastSlow = now;
    pdTick();
    fanTick();
    statusLine(Serial);
    statusLine(Serial1);
    if (now - lastSelfTest > 86400000UL) selfTest(now);
  }
}
