Filip-Kin/frc-radio-kiosk/(commit log)

2026-09-24 FRC radio kiosk v2 and v2b boards, firmware
    [board.kicad_pcb, board.kicad_sch]
2026-09-24 v2b: Ethernet on the left edge, hand-routed power spine, placement DRC clean
    [board.kicad_pcb]
2026-09-24 v2b: Filip's KiCad project (his routing, 2026-09-24 01:00) and the fixed copy: +3V3 net restored, SOIC-8 FET pins, net classes, GND stitching vias
    [board.kicad_sch, radio-kiosk-fixed.kicad_pcb, radio-kiosk-fixed.kicad_sch, radio-kiosk.kicad_pcb]
2026-09-24 v2b fixed board: FETs at 0 deg so the drains meet the hand routes; KiCad 10 DRC clean bar the receptacle's own pad gaps
    [radio-kiosk-fixed.kicad_pcb]
2026-09-24 v2b: schematic audit (six sections against datasheets)
2026-09-24 v2b schematic: audit fixes, port switch, LM3150 laptop rail
    See loon scripts/build-radio-kiosk.ts for the design notes. Net changes are
    listed in NETS-CHANGED.md. PCB not yet updated from this schematic.
    [board.kicad_pcb, board.kicad_sch, radio-kiosk-fixed.kicad_pcb]
2026-09-24 v2b: net change list for the PCB update
2026-09-24 v2b board: updated from the new schematic, routing kept
    Pads re-netted from the netlist (183 changes), tracks follow their pads.
    36 new parts placed by their partners; U4/L3/L4/Q11 land patterns swapped;
    laptop rail re-laid (LM3150, two DPAKs, 10x10 inductor) in the same block.
    Spine edits: buck 5 moved from the VIN spine to +12V, PORT_N stub to D22
    removed (D22 now to GND), VIN tap to C41 moved off C7, LAPTOP_OUT back-side
    run moved from x 13.7 (under U4's thermal vias) to x 17.6 with doubled vias,
    second vias on the VIN input FET drains and the boost feed, USB-C VBUS stubs
    0.3 -> 0.5 mm. Net classes copied into board.kicad_pro with BOOST_OUT,
    BK_MID, U4_SW added. Ethernet untouched. DRC: o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
    [board.kicad_pcb]
2026-09-24 v2b: 3D models by relative path, loon model synced from the board
    [board.kicad_pcb]
2026-09-24 v2b: corrected LCSC codes for the new parts, C25 as the 10 mm 100 V can
    [board.kicad_pcb]
2026-09-24 v2b: E24 basic-library values and LCSC codes on every passive
    [board.kicad_pcb, board.kicad_sch]
2026-09-24 v2b: STM32 in-stock code, 1N4148W basic
    [board.kicad_pcb, board.kicad_sch]
2026-09-24 v2b: U12 EN from BK_EN
    [board.kicad_pcb, board.kicad_sch]
2026-09-24 v2b: LM3150 exposed pad to TI's 3.155x3.255 land
    [board.kicad_pcb]
2026-09-24 v2b: second audit fixes
    Laptop rail: RON 820k (~190 kHz, clears the 725 ns minimum off-time at 20 V),
    L4 15 uH, output bank 22u ceramic + 220u/25V polymer (ESR window), CFF 2.2n,
    RLIM 750R, LAPTOP_OK divider to PC13 for a shorted jack. Port: eFuse ILIM
    5.6k (in the 5.36k-120k range), dV/dt 47n, boost FB 499k (53.7 V, inside the
    LTC4279 window over tolerance), 100k bleeder on BOOST_OUT. Comments fixed.
    [board.kicad_pcb, board.kicad_sch]
2026-09-24 v2b: jack-sense divider moved off the VBUS trace
    [board.kicad_pcb]
2026-09-24 tools: the board update pipeline and JLC pricing scripts
2026-09-24 v2b: interlocked laptop bypass for a 16 V brick
    Q44 SI4401DDY from VIN to +15V6_S (source on VIN, body diode blocks), gate
    through 10k/47k from Q45, BZT52C12 clamp. U45 TLV7011 compares VIN_SENSE with
    a 2.2 V reference that only exists while PC14 LAPTOP_BYP is high, so the
    bypass closes only below ~17.6 V and only on firmware's say-so. Parts along
    the left edge by the laptop rail; front side only. tools: text-based clone
    and placer; the pcbnew swap path dropped 44 footprints once and is retired.
    [board.kicad_pcb, board.kicad_sch]
2026-09-24 v2b: loon model synced from the board
2026-09-24 firmware: v2b pin map and the audit's control changes
    PORT_SW sequencing (boost -> port switch -> PSE, 700 ms window), a board
    without the active parts is detected at the first probe and skipped,
    PORT_SENSE backfeed check on an idle port, eFuse FLT as the passive fault,
    BK_EN active-high arming, USB_DIS while the DC jack is live, laptop sense and
    setpoint at 0.4 V/A with a 4.5 A cap, LAPTOP_OK shorted-jack cut-out, the
    interlocked 16 V bypass on PC14, CRS trim for USB, CH224A at 0x22/0x23 with
    the I2C pins released while USB is absent, new ADC dividers, 8.8 V pack pass.
    71 kB of 128.
    [main.cpp]
2026-09-24 v2b: board restored after loon's save overwrote it; VIN_DC 2 mm, second via on the VIN_USB corner
    [board.kicad_pcb]
2026-09-24 v2b: 2 mm stubs from the input FET drains to the VIN spine
    [board.kicad_pcb]
2026-09-24 v2b: input stubs back to 1.5 mm; Q1/Q2 sources joined to their input runs
    [board.kicad_pcb]
2026-09-24 v2b: library names back on 49 footprints, TVS returns at feed width, two wrong stubs removed
    49 footprints written by the update script had lost their library nickname
    (TO-252-2 instead of Package_TO_SOT_SMD:TO-252-2); KiCad drew them from the
    embedded copy but loon could not resolve them and drew stand-ins, and
    Update PCB would have flagged them all. D1/D2 ground returns: 0.4 mm to one
    via -> 1.5 mm with two vias into the back pour. Removed the VIN_DC and
    VIN_USB stubs added at 14:36 (the VIN_USB one shorted Q1). tools/verify.py
    checks every footprint's pads against its library and every schematic
    part present once.
    [board.kicad_pcb]
2026-09-24 v2b: net classes restored (a loon save at 14:19 had reset board.kicad_pro to Default only)
2026-09-24 v2b: laptop buck corner re-laid; board 84 x 141 (8 mm band at y 36)
    The corner was ~90 % full, so the bypass FET sat on the Ethernet pairs and
    U4's RON/SS/FB/EN/ILIM parts ended up 15-30 mm from their pins. An 8 mm band
    at y = 36 (the only line crossing no part and only straight vertical
    tracks: the four Ethernet runs, VIN_DC, VIN_USB, which just get longer)
    gives the room. Everything below moved as one piece.
    Power stage: Q40 over Q41, gates facing U4, Q40's source lead over Q41's
    tab (short SW), C40/C44 against Q40's tab, L4 under Q41's tab. U4's quiet
    parts in pin order on the strip over the Ethernet (quiet only); BST and ILIM
    beside U4; CC loop in one cell under U4; output C45/C46/R96/U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
    [board.kicad_pcb]
2026-09-24 v2b: loon model re-synced (footprint ids from the file)
2026-09-24 v2b: laptop corner respaced for routing lanes; every silk label placed clear
    Left strip one column with lanes, CC loop in rows with label room, EN and
    PWM-filter resistors moved to the free band; D40 off the battery pin; FET
    pair and input caps up 0.5 mm, L4 down 0.4 mm. tools/labels.py put all 239
    labels just outside their parts, clear of pads, parts and other labels:
    DRC silk_overlap 110 -> 0, silk_over_copper 84 -> 0 (C33's label is 0.7 mm).
    [board.kicad_pcb]
2026-09-24 v2b: front pour GND, back pour +12V
    Back zone moved to +12V (Filip). GND stitching vias that only joined front
    ground to the old back ground pour are gone (72). 18 front +12V pads got a
    0.4 mm stub + via to the back pour (tools/netvias.py); U52's ground pin,
    boxed in by the USB traces, joins the main ground through a via pair and a
    short back jumper. Pours filled with KiCad's filler. Refilled DRC: GND one
    island, +12V open only at U21.3 and Q8.2 (to route), GND open at U40.8,
    U40.35, U1.2, U2.2 (pins between signal pins), errors only J1's pad gaps.
    [board.kicad_pcb]
2026-09-24 v2b: dead copper removed now that both sides are planes
    73 GND stubs with a free end (old stitch stubs; the pads sit in the front
    GND pour), the D1/D2 return stubs and via bars, a no-net back track with its
    via, dead +3V3 and BK_ARM vias, and 13 +12V stub vias on pads that already
    reach +12V. Q6's four drain vias -> pins tied + two 1.0/0.5 vias (3 A);
    U21 IN pins tied to one 0.8/0.4 via; U5 VIN/EN tied to one via. U52's ground
    jumper stays (boxed in by the USB traces). Pours refilled. DRC: errors only
    J1's pad gaps, silk clean, GND one island.
    [board.kicad_pcb]
2026-09-24 v2b: back +12V tracks removed (the pour carries it), PC14 net restored, U52 ground jumper into the main pour
    8 B.Cu +12V segments were redundant under the +12V back pour. U40 pin 3
    (PC14, LAPTOP_BYP) had no net on the board though the schematic has one: the
    pad-net pass had skipped pads with no net field. The U52 ground jumper's far
    via sat in a second pocket inside the VBUS loop; moved to (45, 11.4) in the
    main pour. Refilled; DRC errors only J1's pad gaps; GND and +12V pours each
    one piece; silk clean.
    [board.kicad_pcb]
2026-09-24 v2b: dead PORT_N lead at J5 removed (it ran to D22, which is now PORT_P to GND)
    [board.kicad_pcb]
2026-09-24 v2b: PORT_N and BK_ARM tails left by the earlier removals taken out
    [board.kicad_pcb]
2026-09-24 v2b: Filip's hand routing, moved to 1 oz copper
    Filip's KiCad routing (1013 segments) taken in, then:
    - net classes for 1 oz at ~20 C rise: Heavy 2.0, Wide 1.6, Power 0.8;
    duplicate Power pattern on +15V6_S removed, PORT_SW_G back to Default
    - 199 power segments widened to the new class width where they clear
    every other-net pad, track, via, hole (0.25) and the edge; one VIN_USB
    run kept at 1.5 because widening cut D1's ground off
    - 50 vias added beside single vias on full-width power runs
    (Heavy/Wide 3, Power 2)
    - GND jumpers (via pair + back segment) join three cut-off front GND
    regions (R83, C130, U40.8); R65's region has no room and stays open
    - removed: PORT_N run 0.06 mm from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
    [board.kicad_pcb]
2026-09-24 v2b: Filip's routing pass 2 (U3 caps moved in, PORT_N, PD lines, LED chain)
    [board.kicad_pcb]
2026-09-25 v2b: U3 switch node shortened, Freerouting pass, GND/+12V ties
    - L3 rotated 180 so its switch pad faces U3 pin 8; switch node is now a
    2.0 mm front run (was 12 mm on the back through two 0.3 mm vias)
    - PORT_N J5 lead that threaded the ETH_3/ETH_6 vias removed; the router
    got a keepout west of x 14.5 below y 118 and left PORT_N open
    - Freerouting 5 passes with all existing copper fixed, GND/+12V left to
    the pours: 74 connections routed, dangling leftovers removed
    - 1 oz pass on the result: 41 vias added on single-via power runs
    - U21 pin 3 tied to pins 1-2; Q8 tab tied to the back plane with 3 vias
    - GND jumpers for J1 A1B12, J12 shield/GND, R60, U12.2, U42/C116 islands
    - net classes: U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
    [board.kicad_pcb]
2026-09-25 v2b: PORT_N routed from J5
    J5 pins 7/8 sit inside both pairs' breakout (ETH_3/6 on the front and
    ETH_1/2 on the back, stacked at y 131), so every exit crosses a pair.
    Single-net grid route, 0.8 mm, 0.7 mm from Ethernet copper on the same
    layer, with a 40x cost for running over Ethernet on the other layer:
    front west from pin 8 under the ETH_3/6 run, up beside PORT_P over the
    ETH_1/2 back pair for ~5 mm, across the pairs' diagonal to a via pair at
    (11.4-12.5, 122), back diagonal to the PORT_N spine at (24.5, 110).
    [board.kicad_pcb]
2026-09-25 v2c: 95x140 board, connectivity-driven placement, MCU pin map from layout, autorouted
    - outline 95 x 140 (11 mm wider); connectors where v2b had them, right-edge
    parts out 11 mm; Ethernet copper carried over and continuous
    - placement by tools/placer: blocks by connectivity, power stages as rigid
    macros (laptop buck core from v2b; 12 V/5 V/boost/output-diode solved:
    switch nodes 5/4/12 mm), decoupling caps at their IC, TVS at connectors,
    fan passives at the fan header, MCU in the middle
    - MCU GPIO map chosen by the placer (mcu-pins.json); schematic regenerated
    with it (KIOSK_MCU_PINS), firmware pin table + TIM3_CH1 on PB4 and
    TIM1_CH1 on PA8 updated, builds
    - Freerouting: class w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
    [board.kicad_pcb, board.kicad_sch]
2026-09-25 v2d: 4-layer rework, 85 x 120 mm, power-first routing, 1 connection open
    In1 is a solid GND plane, In2 carries signals with a GND fill, power stays on
    the outer 1 oz layers. Ports keep their spots (top edge unchanged, right and
    bottom edges keep their distance from the edge), the approved Ethernet pairs
    keep their route with shorter straight runs. Placement is v2c's placer with an
    FFT legaliser, same-footprint swaps and a corrected cap-to-IC table; the MCU
    pin map follows the layout and the schematic and firmware are regenerated from
    it (no net differences, firmware builds).
    KiCad DRC: 1 unconnected (USB_ISENSE, U41 pin 1 to U40 pin 10), no copper
    errors. NOTES.md lists what to review befor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
    [board.kicad_pcb, board.kicad_sch]
2026-09-25 v2d: fully routed, nothing foreign under the inductors, fab files
    - Copper under L3/L4/L5/L20 ripped and re-routed with a keep-out: no signal on
    any layer, no foreign net on F.Cu or In2; power may pass on B.Cu under the
    In1 plane (FAN_N under L20 does).
    - Last open net closed by a pin swap: USB_ISENSE PA0 -> PA3, PORT_SW PA3 ->
    PC15; schematic and firmware regenerated.
    - KiCad DRC: 0 unconnected, no copper errors. fab/: gerbers, drill, JLC BOM
    and CPL.
    [board.kicad_pcb, board.kicad_sch, v2d-bom-jlc.csv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]
2026-09-26 v2d: rounded board corners (R4, concentric with the M3 holes), gerbers regenerated
    [board.kicad_pcb]
2026-09-26 v2d: SMT-only JLC BOM/CPL (through-hole connectors and battery holders hand-fitted)
    [v2d-bom-jlc-smt.csv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]
2026-09-26 v2d: JLC BOM lists every designator (JLC does not expand C131-C133 ranges)
    [v2d-bom-jlc.csv]
2026-09-26 v2d: XLSX BOM/CPL (JLC's upload rejected the CSV versions; XLSX went through)
    [v2d-bom-jlc-smt.xlsx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]
2026-09-26 v2d: C46 back to the 220u/25V polymer (C2981459), C44 to 10u/50V (C53084452)
    A stale 'C44-C47 = 22u/25V 1210' line in the generator's LCSC table
    overrode both: C46 became a 22u ceramic (the LM3150 needs the polymer's
    ESR) and C44, on VIN up to 26 V, a 25 V part. Caught in JLC's matching sheet.
    [board.kicad_pcb, board.kicad_sch, v2d-bom-jlc-smt.csv, v2d-bom-jlc-smt.xlsx, v2d-bom-jlc.csv]
2026-09-26 v2d: BOM/CPL with the top-side THT connectors (no battery holders, no J9/J11 headers)
    [v2d-bom-jlc-smt-tht.xlsx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]
2026-10-11 v1: built board (EasyEDA fab export 2026-03-25) and KiCad schematic draft
    The README pointed at a root Radio_Kiosk_Circuit.kicad_sch that was never
    tracked. v1 now has its own directory like v2-v2d. Files copied from
    Robots/Radio Kiosk Circuit/; the empty .kicad_pcb (board lived in EasyEDA)
    and KiCad backups/.history are left out.
    [3D_PCB1_2026-03-25.step, BOM_Board1_PCB1_2026-03-25.xlsx, Radio Kiosk Circuit.kicad_sch]
